Queens-Rocket-Engineering-Team/av-prop/Schematics/lower_lc_board/models/1053141106.stp

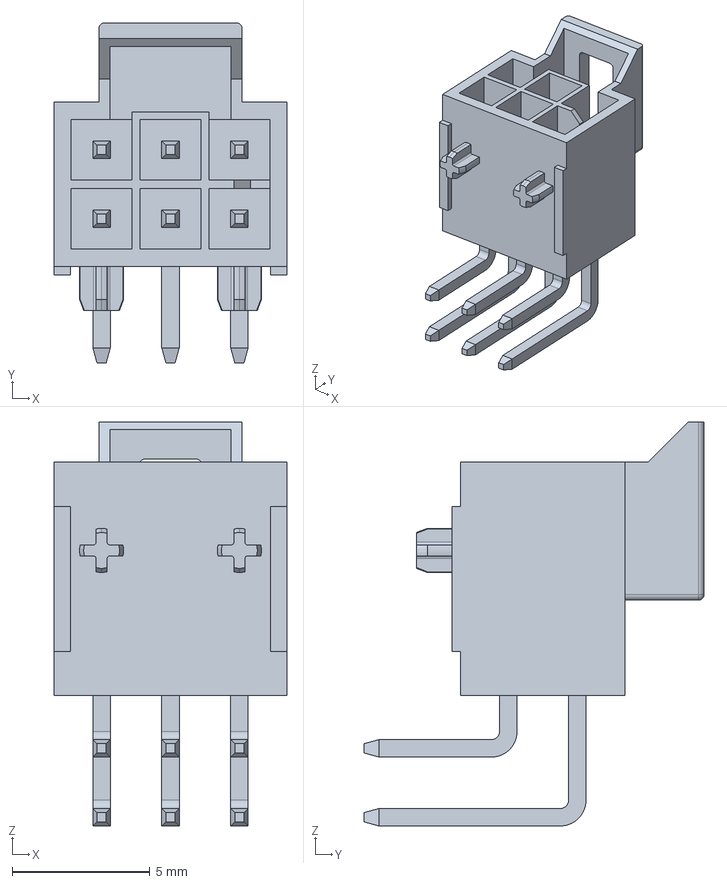
[picture p8: CAD file, 2026-06-11]
Schematics/lower_lc_board/models/1053141106.stp
8.44 x 12.3 x 14.7 mm
