Queens-Rocket-Engineering-Team/av-prop/Schematics/lower_lc_board/models/1984769.stp

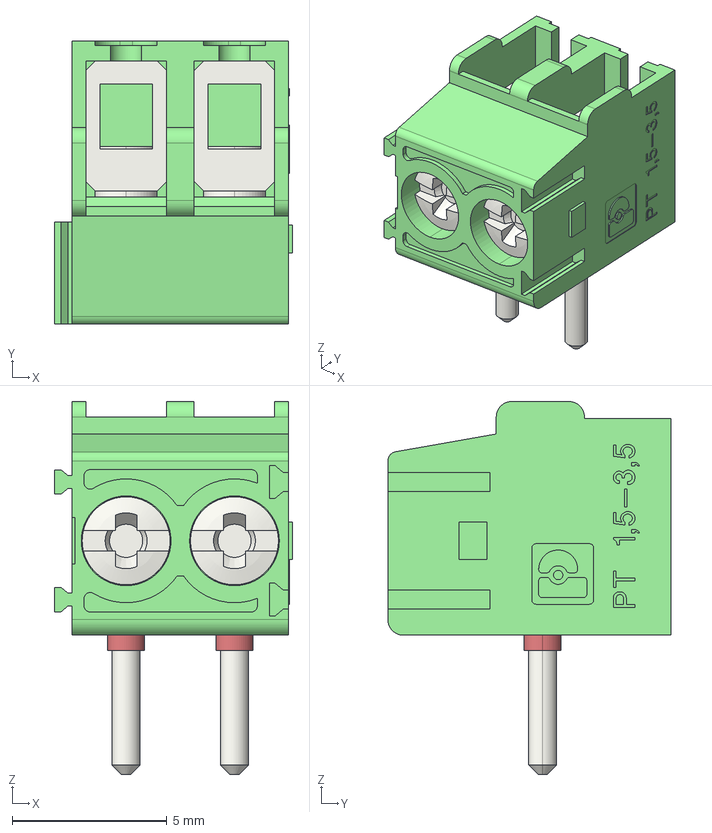
[picture p9: CAD file, 2026-06-11]
Schematics/lower_lc_board/models/1984769.stp
7.70 x 9.15 x 12.1 mm
Bohrloch x 2
AC_PT_1_5_PVH_H0_Schraube x 2
LP_PT_1_5_KLH_3_5 x 2
PT_1.5_3_3.50_V_GEH
