Queens-Rocket-Engineering-Team/av-prop/Schematics/lower_lc_board/lower_lc_board.kicad_pcb

## KiCad design Schematics/lower_lc_board/lower_lc_board.kicad_pcb (2026-06-11)

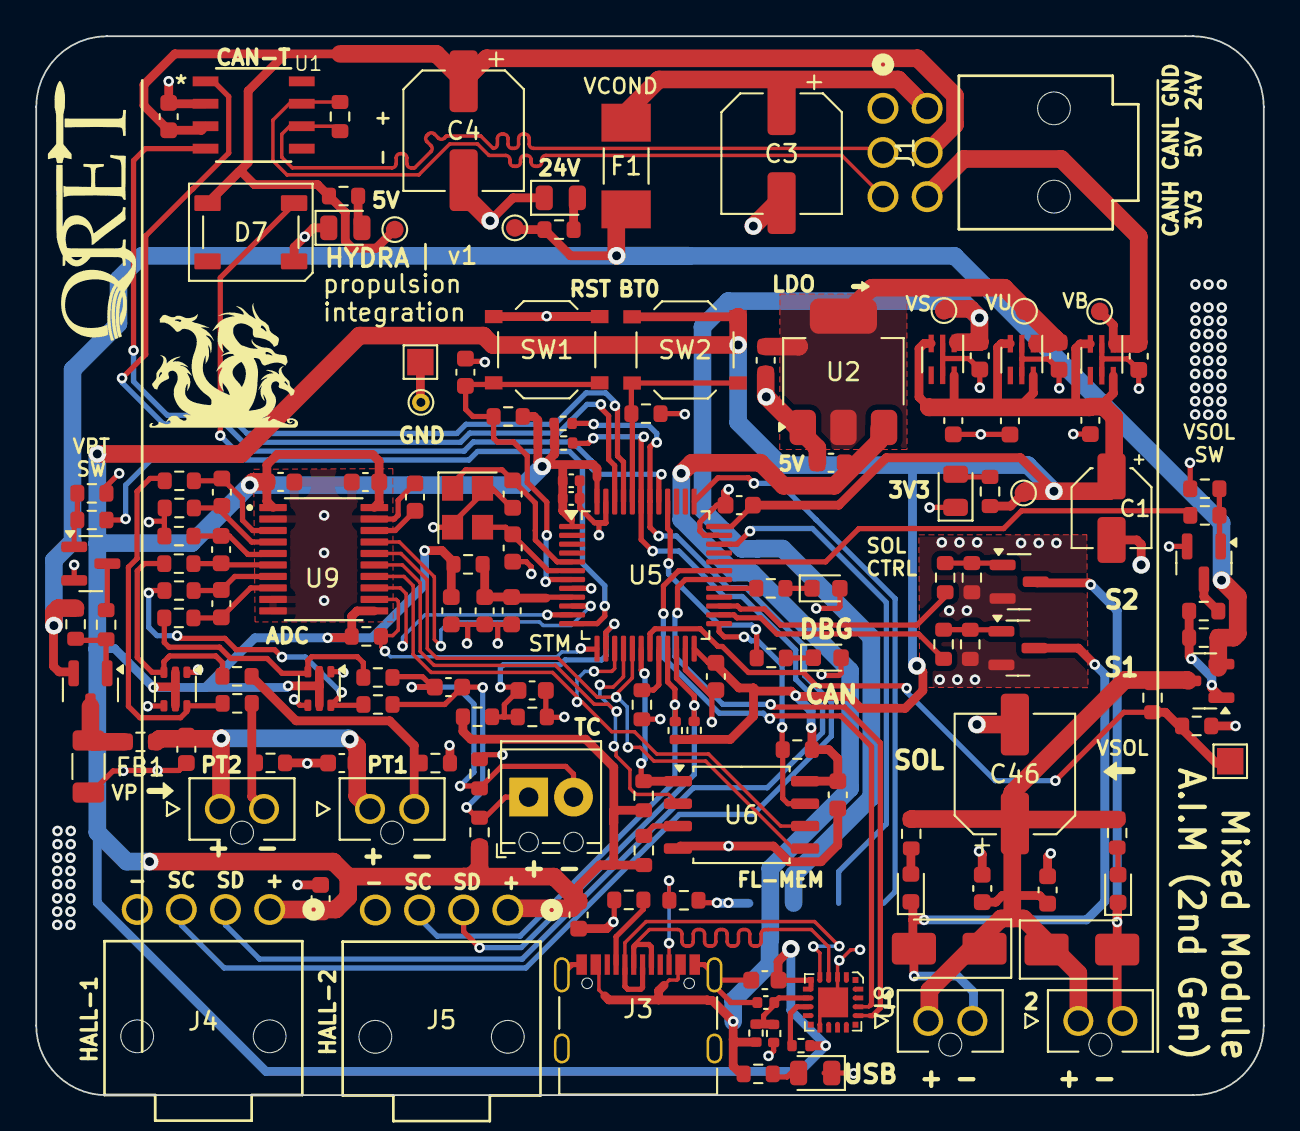
[picture p10: board lower_lc_board.kicad_pcb from above]

Board: 4 copper layers, 69.5 x 60.0 mm, 149 parts (1 on the bottom side), 86 nets.

Parts:
C1: 10uF; CP_Elec_4x5.4
C2, C18, C23, C30, C33, C39, C41, C45, C52: 0.1uF; C_0603_1608Metric
C3, C4, C46: 100uF; CP_Elec_6.3x5.9
C5, C6, C28, C43, C44, C48, C49: 1uF; C_0603_1608Metric
C7, C12, C21, C50: 10uF; C_0603_1608Metric
C8, C9, C17: 100nF; C_0603_1608Metric
C10, C11: 10p; C_0603_1608Metric
C13, C14: 100n; C_0402_1005Metric
C15, C16: 100n; C_0603_1608Metric
C20: 1uF; C_0402_1005Metric
C26, C27, C34, C56: 10nF; C_0603_1608Metric
C29: 220 nF; C_0603_1608Metric
C35: 10uF; C_1206_3216Metric
C51: 1nF; C_0603_1608Metric
D1: PWR_3V3_LED (GRN); LED_0805_2012Metric
D2: PWR_24V_LED (GRN); LED_0805_2012Metric
D3: PWR_5V_LED (GRN); LED_0805_2012Metric
D4: USB_LED (GRN); LED_0805_2012Metric
D5: DB_LED (YLW); LED_0603_1608Metric
D6: CAN_LED (WHT); LED_0603_1608Metric
D7: SYS_LED; LED_WS2812B_PLCC4_5.0x5.0mm_P3.2mm
D11: SOL2_LED (YELW); LED_0603_1608Metric
D12: SOL1_LED (YELW); LED_0603_1608Metric
D13, D18: BAV199DW; SOT-363_SC-70-6
D15, D16: SS34; D_SMA
F1: Fuse; FUSC6125X279N
FB1, FB2: 600R; R_0603_1608Metric
J1: Conn_01x06; CONN_SD-105314-100_06_MOL
J2: SWD_CONN; SWD_PinHeader_1x04_P2.54mm_Horizontal_SMD
J3: USB_C_CONN; USB_C_DB-108PWB
J4: HALL-1; CONN_SD-105313-100_04_MOL
J5: HALL-2; CONN_SD-105313-100_04_MOL
J6, J8: PT; MOLEX_1053091102
J7: Screw_Terminal_01x02; TerminalBlock_Phoenix_MPT-0,5-2-2.54_1x02_P2.54mm_Horizontal
J9, J10: SOL_CONN; MOLEX_1053091102
Q1, Q2: AO3400A; SOT-23
Q3, Q5: 2N7002; SOT-23
R1: 3.3k; R_0603_1608Metric
R2, R30, R31: 12k; R_0603_1608Metric
R3, R16, R23, R51: 6.2k; R_0603_1608Metric
R5, R6, R7, R8, R22, R25, R43, R48, R49, R50, R52, R54, R60: 10k; R_0603_1608Metric
R9, R10: 5.1k; R_0603_1608Metric
R11: 22k; R_0402_1005Metric
R12: 47k; R_0402_1005Metric
R13: 1k; R_0402_1005Metric
R14: 680; R_0603_1608Metric
R15: 270; R_0603_1608Metric
R17, R18, R21, R45: 2.2k; R_0402_1005Metric
R19, R20: 1.2k; R_0603_1608Metric
R24, R28, R33, R37: 1k; R_0603_1608Metric
R26, R27: 1M; R_0603_1608Metric
R29, R34, R36, R38, R40, R41, R44, R53: 200; R_0603_1608Metric
R32, R35: 62; R_0603_1608Metric
R39, R42, R47: 100k; R_0603_1608Metric
R46: 120; R_0603_1608Metric
SW1: SW_STM_RESET; SW_Push_1P1T_XKB_TS-1187A
SW2: SW_STM_BOOT_MODE; SW_Push_1P1T_XKB_TS-1187A
TH1: Thermistor; R_0603_1608Metric
TP1: 24V-TP; TestPoint_Pad_D1.0mm
TP2: 3V3-TP; TestPoint_Pad_D1.0mm
TP3: GND-TP-H; TestPoint_THTPad_D1.0mm_Drill0.5mm
TP4: 3V3_BP; TestPoint_Pad_D1.0mm
TP5: GND-TP-P; TestPoint_Pad_1.5x1.5mm
TP6: 3V3_USB; TestPoint_Pad_D1.0mm
TP7: VSOL.S; TestPoint_Pad_1.5x1.5mm
TP9: V_SWD_TP; TestPoint_Pad_D1.0mm
TP13: 5V-TP; TestPoint_Pad_D1.0mm
U1: TCAN1051HGVDR; SOIC_1044BDR_TEX
U2: AMS1117-3.3; SOT-223-3_TabPin2
U3, U4, U10: ID_LM66100DCKR; SC-70-6
U5: STM32F103CBT6; LQFP-48_7x7mm_P0.5mm
U6: BY25Q128ES; SOIC-8_5.23x5.23mm_P1.27mm
U8: CP2102N-Axx-xQFN20; QFN-20-1EP_3x3mm
U9: ADC_ADS131M04IPWR; SOP65P640X120-20N
U11, U12: DMP4065S-7; SOT-23
Y1: X322516MMB4SI; Crystal_SMD_3225-4Pin_3.2x2.5mm

Connections:
5V_USB: C7.1, J3.A4 (VBUS), J3.A9 (VBUS), J3.B4 (VBUS), J3.B9 (VBUS), R11.2, R16.1, U2.3 (VI)
+3.3VA: C45.2, C48.2, FB2.1, U5.9 (VDDA)
+3V3: C1.1, C13.1, C14.1, C15.1, C16.1, C17.1, C21.2, C23.1, C28.2, C30.2, C33.1, C43.2, C49.1, C50.1, C51.1, C52.1, D13.2 (K2), D13.5 (K4), D18.2 (K2), D18.5 (K4), FB2.2, J4.1, J5.1, J7.1, R1.1, R6.2, R7.2, R8.2, R13.2, R17.2, R18.1, R21.2, R24.2, R25.2, R26.1, R26.2, R45.1, R48.1, R49.2, SW2.2, TP2.1, U3.3 (*CE), U3.6 (VOUT), U4.3 (*CE), U4.6 (VOUT), U5.1 (VBAT), U5.24 (VDD), U5.36 (VDD), U5.48 (VDD), U6.8 (VCC), U8.6 (VDD), U8.7 (VREGIN), U9.1 (AVDD), U9.11 (~SYNC/~RESET), U9.20 (DVDD), U10.3 (*CE), U10.6 (VOUT)
+5V: C4.1, C9.2, D7.1 (VDD), J1.5, R3.2, TP13.1, U1.3 (VCC)
+24V: F1.1, R2.2, R23.2, R51.2, TP1.1, U11.2 (S), U12.2 (S)
+24V_BP: C3.1, F1.2, J1.4
/Power Circuitry/3V3_BP: C5.2, J1.6, TP4.1, U3.1 (VIN)
/Power Circuitry/3V3_USB: C6.1, C12.1, TP6.1, U2.2 (VO), U4.1 (VIN)
/Sensing Circuitry/PT1_CLAMPED: C26.2, R34.1, U9.3 (AIN0P)
/Sensing Circuitry/PT2_CLAMPED: C27.2, R38.1, U9.6 (AIN1P)
/Sensing Circuitry/TC_N_1: C30.1, J7.2, R27.1, R28.2
/Sensing Circuitry/TC_N_CLAMPED_1: C56.1, R40.2, U9.8 (AIN2N)
/Sensing Circuitry/TC_P_CLAMPED_1: C56.2, R29.2, U9.7 (AIN2P)
/Valve Control Circuitry/VSOL: C39.1, C41.1, C46.1, D15.1 (K), D16.1 (K), J9.1, J10.1, R30.2, R31.2, R47.1, U12.3 (D)
ADC_CLKIN: U5.10 (PA0), U9.17 (CLKIN)
ADC_CS: R49.1, U5.13 (PA3), U9.12 (~CS)
ADC_DRDY: U5.11 (PA1), U9.13 (~DRDY)
BOOT0: R5.2, SW2.1, U5.44 (BOOT0)
BOOT1: R60.2, U5.20 (PB2)
CAN_LED: R15.1, U5.40 (PB4)
CAN_N: J1.2, R46.1, U1.6 (CANL)
CAN_P: J1.3, R46.2, U1.7 (CANH)
CAN_RX: U1.4 (RXD), U5.45 (PB8)
CAN_TX: U1.1 (TXD), U5.46 (PB9)
CJC_SENSE: C34.2, R25.1, TH1.1, U5.14 (PA4)
DB_LED: R14.1, U5.29 (PA8)
FL_CS: R48.2, U5.18 (PB0), U6.1 (~CS)
GND: C1.2, C2.2, C3.2, C4.2, C5.1, C6.2, C7.2, C8.2, C9.1, C10.2, C11.2, C12.2, C13.2, C14.2, C15.2, C16.2, C17.2, C18.2, C20.1, C21.1, C23.2, C28.1, C29.2, C33.2, C34.1, C35.2, C39.2, C41.2, C43.1, C44.2, C45.1, C46.2, C48.1, C49.2, C50.2, C51.2, C52.2, D1.1 (K), D2.1 (K), D3.1 (K), D4.1 (K), D5.2 (A), D6.2 (A), D7.3 (VSS), D13.1 (A1), D13.4 (A3), D18.1 (A1), D18.4 (A3), J1.1, J2.1 (GND), J3.A1 (GND), J3.A12 (GND), J3.B1 (GND), J3.B12 (GND), J3.S1 (SHIELD), J4.4, J5.4, Q1.2 (S), Q2.2 (S), Q3.2 (S), Q5.2 (S), R5.1, R9.2, R10.2, R12.1, R19.1, R20.1, R27.2, R32.1, R35.1, R39.1, R42.1, R43.1, R52.1, R54.1, R60.1, SW1.1, TH1.2, TP3.1, TP5.1, U1.2 (GND), U2.1 (ADJ), U3.2 (GND), U3.5 (ST), U4.2 (GND), U4.5 (ST), U5.8 (VSSA), U5.23 (VSS), U5.35 (VSS), U5.47 (VSS), U6.4 (GND), U8.3 (GND), U8.12 (GND), U8.21 (GND), U9.2 (AGND), U9.9 (AIN3N), U9.10 (AIN3P), U9.19 (DGND), U10.2 (GND), U10.5 (ST), Y1.2, Y1.4
HALL_SCL1: J4.3, R18.2, U5.42 (PB6)
HALL_SCL2: J5.3, R45.2, U5.21 (PB10)
HALL_SDA1: J4.2, R17.1, U5.43 (PB7)
HALL_SDA2: J5.2, R21.1, U5.22 (PB11)
unnamed: D1.2 (A), R1.2
unnamed: D2.2 (A), R2.1
unnamed: D3.2 (A), R3.1
unnamed: D4.2 (A), R16.2
unnamed: D5.1 (K), R14.2
unnamed: D6.1 (K), R15.2
unnamed: D11.2 (A), R30.1
unnamed: D12.2 (A), R31.1
unnamed: D13.6 (K3A4), R33.2, R34.2
unnamed: D13.3 (K1A2), R37.2, R38.2
unnamed: D18.6 (K3A4), R24.1, R29.1
unnamed: D18.3 (K1A2), R28.1, R40.1
unnamed: J3.A5 (CC1), R9.1
unnamed: J3.B5 (CC2), R10.1
unnamed: J6.2, R32.2, R33.1
unnamed: J8.2, R35.2, R37.1
unnamed: Q1.1 (G), R36.1, R39.2
unnamed: Q2.1 (G), R41.1, R42.2
unnamed: Q3.3 (D), R22.1
unnamed: Q3.1 (G), R43.2, R44.2
unnamed: Q5.3 (D), R50.1
unnamed: Q5.1 (G), R52.2, R53.2
unnamed: R8.1, U6.3 (IO2)
unnamed: C20.2, R11.1, R12.2, U8.8 (VBUS)
unnamed: R13.1, U8.9 (~RST)
unnamed: C26.1, R19.2, U9.4 (AIN0N)
unnamed: C27.1, R20.2, U9.5 (AIN1N)
unnamed: C29.1, U9.18 (CAP)
unnamed: C35.1, FB1.2, U11.3 (D)
unnamed: R22.2, R23.1, U11.1 (G)
unnamed: R50.2, R51.1, U12.1 (G)
OSC_IN: C10.1, U5.5 (PD0), Y1.1
OSC_OUT: C11.1, U5.6 (PD1), Y1.3
RESET_FL: R7.1, U5.25 (PB12), U6.7 (IO3)
RGB_DATA: D7.4 (DIN), U5.41 (PB5)
SOL1_EN: R36.2, U5.26 (PB13)
SOL1_RET: D12.1 (K), D16.2 (A), J10.2, Q1.3 (D)
SOL2_EN: R41.2, U5.27 (PB14)
SOL2_RET: D11.1 (K), D15.2 (A), J9.2, Q2.3 (D)
SPI_MISO: U5.16 (PA6), U6.2 (DO(IO1)), U9.15 (DOUT)
SPI_MOSI: U5.17 (PA7), U6.5 (DI(IO0)), U9.16 (DIN)
SPI_SCLK: U5.15 (PA5), U6.6 (CLK), U9.14 (SCLK)
STM_RESET: C8.1, R6.1, SW1.2, U5.7 (NRST)
SWCLK: J2.4 (SWCLK), U5.37 (PA14)
SWDIO: J2.3 (SWDIO), U5.34 (PA13)
USART_RX: U5.31 (PA10), U8.18 (TXD)
USART_TX: U5.30 (PA9), U8.17 (RXD)
USB_N: J3.A7 (D-), J3.B7 (D-), U8.5 (D-)
USB_P: J3.A6 (D+), J3.B6 (D+), U8.4 (D+)
VPT: C2.1, C18.1, FB1.1, J6.1, J8.1
VPT_EN: R44.1, U5.12 (PA2)
VSOL_EN: R53.1, U5.32 (PA11)
VSOL_SENSE: R47.2, R54.2, TP7.1, U5.19 (PB1)
V_SWD: C44.1, J2.2 (3V3), TP9.1, U10.1 (VIN)
