Queens-Rocket-Engineering-Team/av-prop/Schematics/upper_lc_board/upper_lc_board.kicad_pcb

## KiCad design Schematics/upper_lc_board/upper_lc_board.kicad_pcb (2026-06-11)

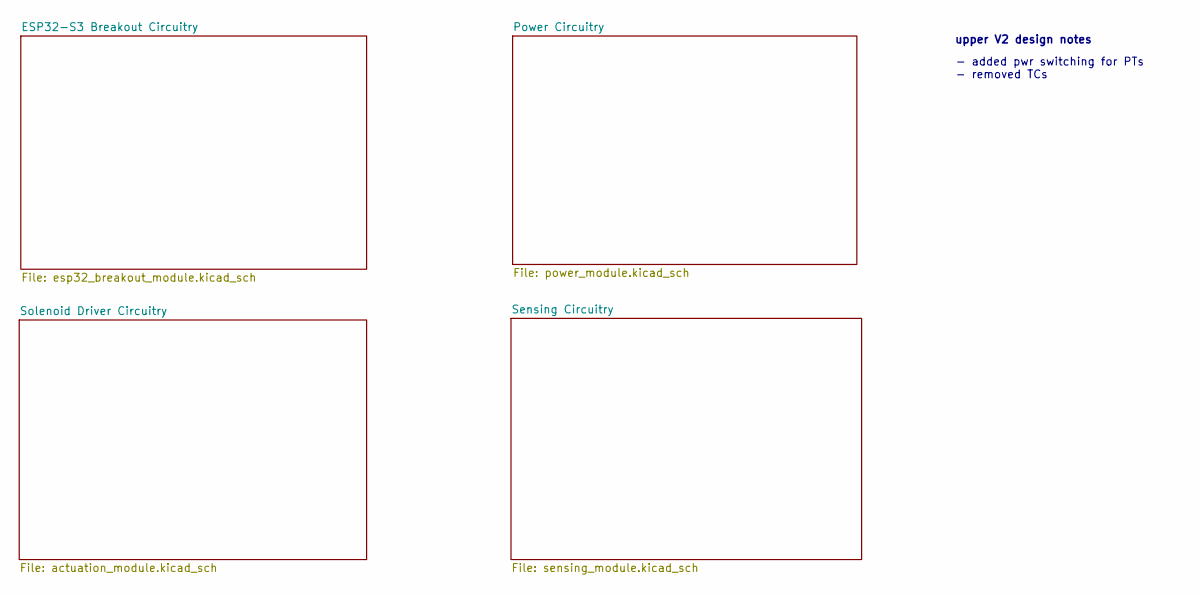
[picture p11: schematic upper_lc_board.kicad_sch, QRET 25-26 SRAD Hybrid Upper Control Module]

Notes on the sheet:
- added pwr switching for PTs - removed TCs
upper V2 design notes

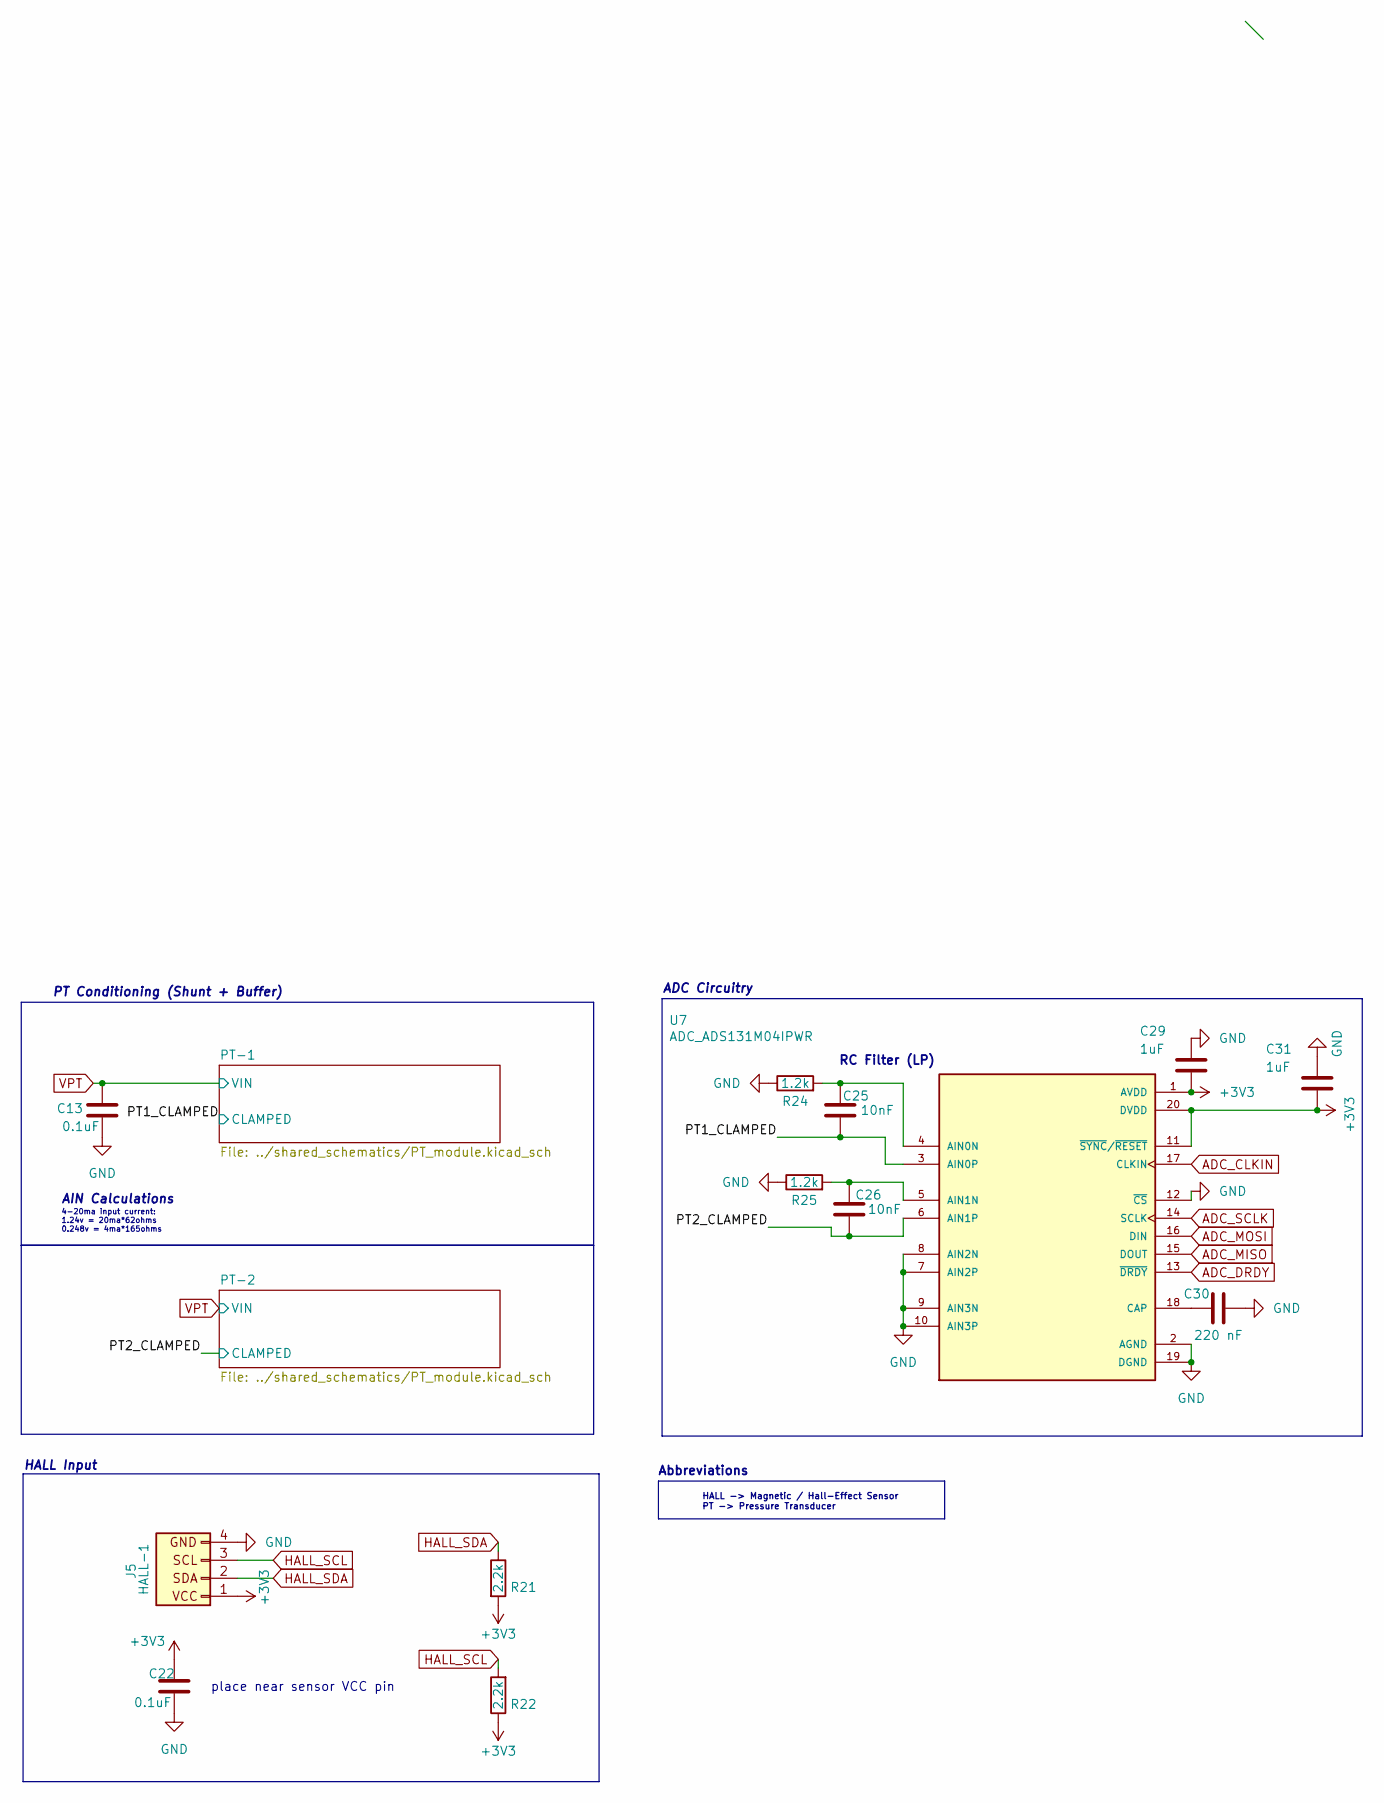
[picture p12: schematic sensing_module.kicad_sch, Sensing Circuitry]

Parts:
C13, C22: 0.1uF; C_0603_1608Metric; LCSC C14663
C25, C26: 10nF; C_0603_1608Metric; LCSC C57112
C29, C31: 1uF; C_0603_1608Metric; LCSC C15849
C30: 220 nF; C_0603_1608Metric; LCSC C21120
J5: HALL-1; CONN_SD-105313-100_04_MOL; Digikey WM16895-ND
R21, R22: 2.2k; R_0603_1608Metric; LCSC C4190
R24, R25: 1.2k; R_0603_1608Metric; LCSC C22765
U7: ADC_ADS131M04IPWR; SOP65P640X120-20N; PARTREV D; LCSC C2862562

Connections:
+3V3: C22.1, C29.2, C31.2, J5.1, R21.2, R22.1, U7.1 (AVDD), U7.11 (~SYNC/~RESET), U7.20 (DVDD); also elsewhere on the board
/Sensing Circuitry/PT1_CLAMPED: C25.2, U7.3 (AIN0P); also elsewhere on the board
/Sensing Circuitry/PT2_CLAMPED: C26.2, U7.6 (AIN1P); also elsewhere on the board
ADC_CLKIN: U7.17 (CLKIN); also elsewhere on the board
ADC_DRDY: U7.13 (~DRDY); also elsewhere on the board
ADC_MISO: U7.15 (DOUT); also elsewhere on the board
ADC_MOSI: U7.16 (DIN); also elsewhere on the board
ADC_SCLK: U7.14 (SCLK); also elsewhere on the board
GND: C13.2, C22.2, C29.1, C30.2, C31.1, J5.4, R24.1, R25.1, U7.2 (AGND), U7.7 (AIN2P), U7.8 (AIN2N), U7.9 (AIN3N), U7.10 (AIN3P), U7.12 (~CS), U7.19 (DGND); also elsewhere on the board
HALL_SCL: J5.3, R22.2; also elsewhere on the board
HALL_SDA: J5.2, R21.1; also elsewhere on the board
unnamed: C25.1, R24.2, U7.4 (AIN0N)
unnamed: C26.1, R25.2, U7.5 (AIN1N)
unnamed: C30.1, U7.18 (CAP)
VPT: C13.1; also elsewhere on the board

Notes on the sheet:
4-20ma input current: 1.24v = 20ma*62ohms 0.248v = 4ma*165ohms
HALL -> Magnetic / Hall-Effect Sensor PT -> Pressure Transducer
place near sensor VCC pin
ADC Circuitry
AIN Calculations
RC Filter (LP)
HALL Input
PT Conditioning (Shunt + Buffer)
Abbreviations

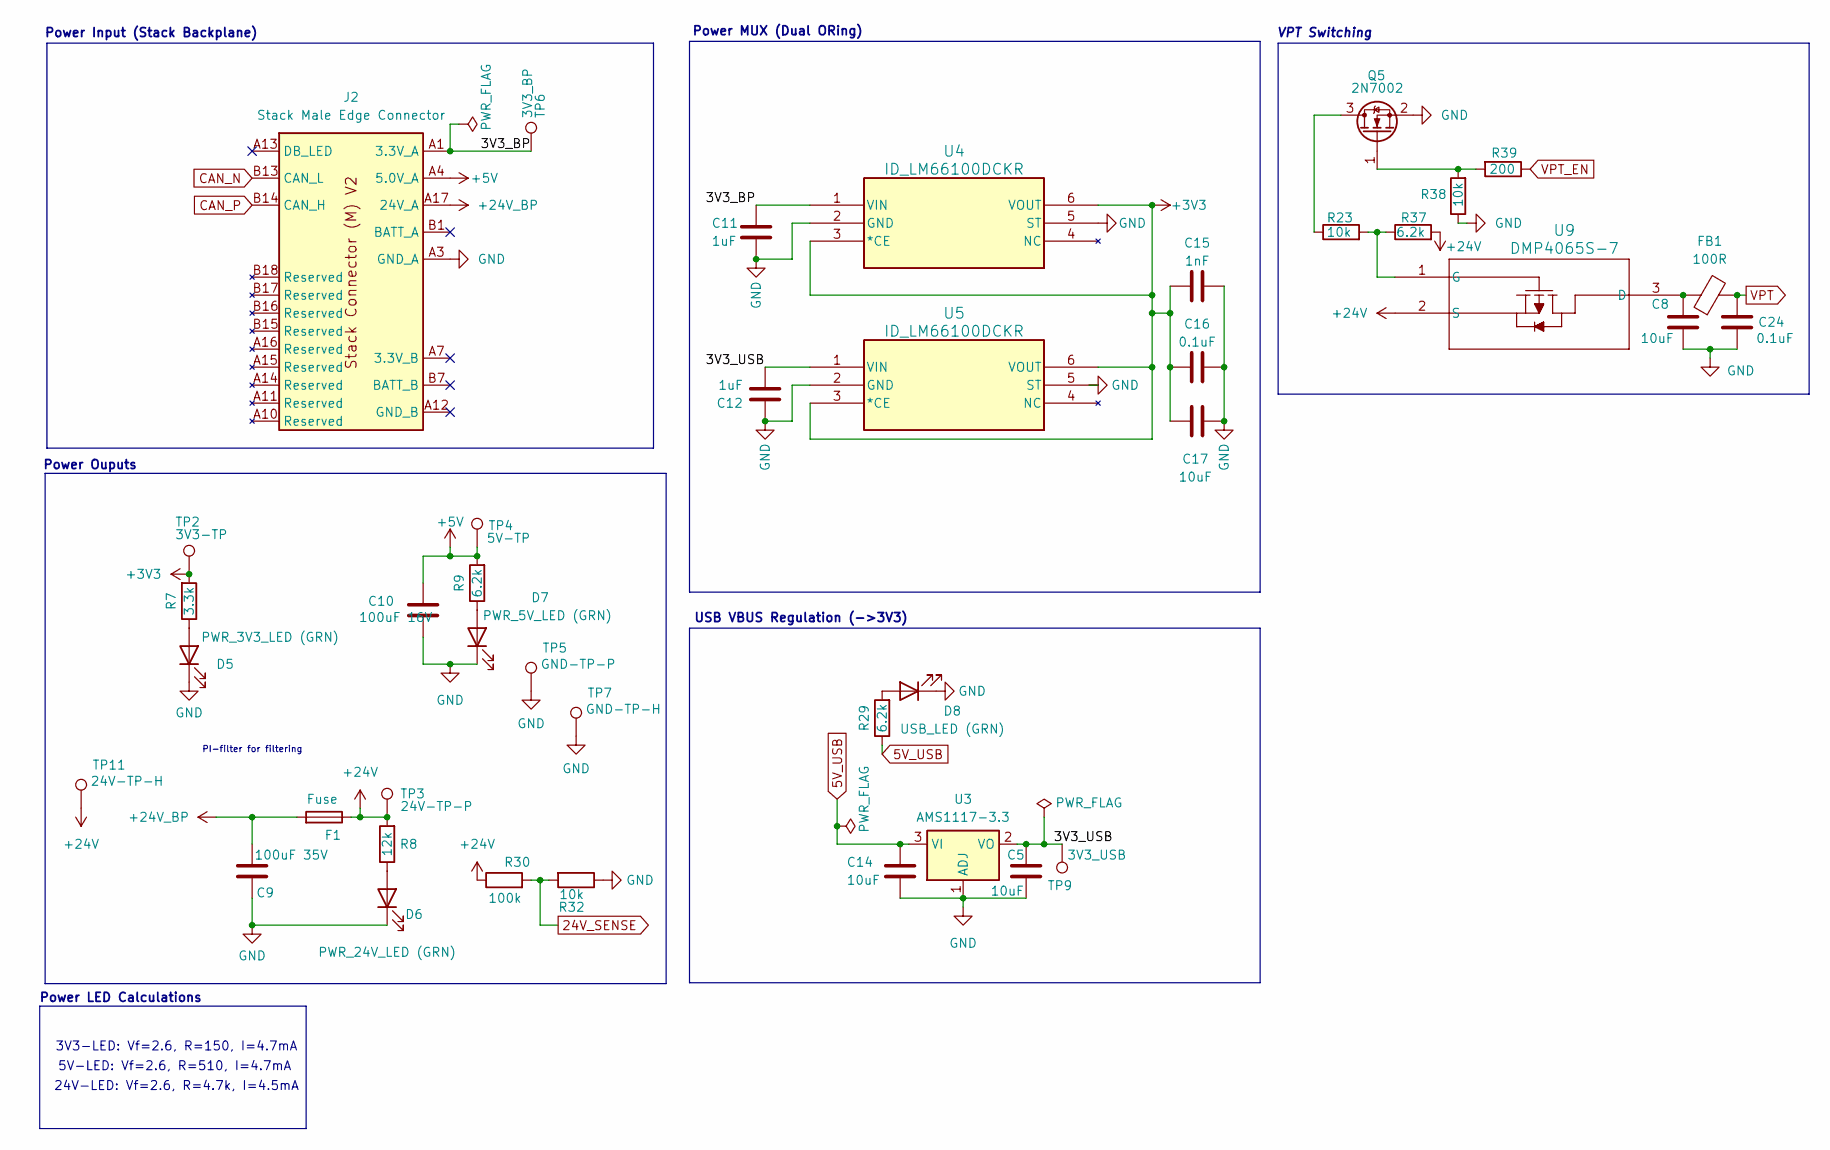
[picture p13: schematic power_module.kicad_sch, Power Management Circuitry]

Parts:
C5, C8, C14, C17: 10uF; C_0603_1608Metric; LCSC C96446
C9: 100uF 35V; CP_Elec_6.3x5.9; Digikey 732-8511-1-ND
C10: 100uF 16V; CP_Elec_6.3x5.9; Digikey 732-8419-1-ND
C11, C12: 1uF; C_0603_1608Metric; LCSC C15849
C15: 1nF; C_0603_1608Metric; LCSC C1588
C16, C24: 0.1uF; C_0603_1608Metric; LCSC C14663
D5: PWR_3V3_LED (GRN); LED_0805_2012Metric; LCSC C2297
D6: PWR_24V_LED (GRN); LED_0805_2012Metric; LCSC C2297
D7: PWR_5V_LED (GRN); LED_0805_2012Metric; LCSC C2297
D8: USB_LED (GRN); LED_0805_2012Metric; LCSC C2297
F1: Fuse; FUSC6125X279N; Digikey 5923-0679H2000-05CT-ND
FB1: 100R; R_0805_2012Metric; LCSC C1015
J2: Stack Male Edge Connector; BUS_PCIexpress_x1
Q5: 2N7002; SOT-23; LCSC C8545
R7: 3.3k; R_0603_1608Metric; LCSC C22978
R8: 12k; R_0603_1608Metric; LCSC C22790
R9, R29, R37: 6.2k; R_0603_1608Metric; LCSC C4260
R23, R32, R38: 10k; R_0603_1608Metric; LCSC C25804
R30: 100k; R_0603_1608Metric; LCSC C25803
R39: 200; R_0603_1608Metric; LCSC C8218
TP2: 3V3-TP; TestPoint_Pad_D1.0mm
TP3: 24V-TP-P; TestPoint_Pad_1.5x1.5mm
TP4: 5V-TP; TestPoint_Pad_D1.0mm
TP5: GND-TP-P; TestPoint_Pad_1.5x1.5mm
TP6: 3V3_BP; TestPoint_Pad_D1.0mm
TP7: GND-TP-H; TestPoint_THTPad_D1.0mm_Drill0.5mm
TP9: 3V3_USB; TestPoint_Pad_D1.0mm
TP11: 24V-TP-H; TestPoint_THTPad_D1.0mm_Drill0.5mm
U3: AMS1117-3.3; SOT-223-3_TabPin2; LCSC C6186
U4, U5: ID_LM66100DCKR; SC-70-6; LCSC C2869734
U9: DMP4065S-7; SOT-23; LCSC C182476

Connections:
5V_USB: C14.1, R29.1, U3.3 (VI); also elsewhere on the board
24V_SENSE: R30.2, R32.2; also elsewhere on the board
+3V3: C15.1, C16.1, C17.1, R7.2, TP2.1, U4.3 (*CE), U4.6 (VOUT), U5.3 (*CE), U5.6 (VOUT); also elsewhere on the board
+5V: C10.1, J2.A4 (5.0V_A), J2.A5 (5.0V_A), R9.2, TP4.1; also elsewhere on the board
+24V: F1.1, R8.2, R30.1, R37.2, TP3.1, TP11.1, U9.2 (S); also elsewhere on the board
+24V_BP: C9.1, F1.2, J2.A17 (24V_A), J2.A18 (24V_A)
/Power Circuitry/3V3_BP: C11.2, J2.A1 (3.3V_A), J2.A2 (3.3V_A), TP6.1, U4.1 (VIN)
/Power Circuitry/3V3_USB: C5.1, C12.1, TP9.1, U3.2 (VO), U5.1 (VIN)
CAN_N: J2.B13 (CAN_L); also elsewhere on the board
CAN_P: J2.B14 (CAN_H); also elsewhere on the board
GND: C5.2, C8.2, C9.2, C10.2, C11.1, C12.2, C14.2, C15.2, C16.2, C17.2, C24.2, D5.1 (K), D6.1 (K), D7.1 (K), D8.1 (K), J2.A3 (GND_A), J2.A6 (GND_A), J2.B4 (GND_A), J2.B5 (GND_A), J2.B6 (GND_A), Q5.2 (S), R32.1, R38.1, TP5.1, TP7.1, U3.1 (ADJ), U4.2 (GND), U4.5 (ST), U5.2 (GND), U5.5 (ST); also elsewhere on the board
unnamed: D5.2 (A), R7.1
unnamed: D6.2 (A), R8.1
unnamed: D7.2 (A), R9.1
unnamed: D8.2 (A), R29.2
unnamed: Q5.3 (D), R23.1
unnamed: Q5.1 (G), R38.2, R39.2
unnamed: C8.1, FB1.1, U9.3 (D)
unnamed: R23.2, R37.1, U9.1 (G)
VPT: C24.1, FB1.2; also elsewhere on the board
VPT_EN: R39.1; also elsewhere on the board

Notes on the sheet:
Power Input (Stack Backplane)
24V-LED: Vf=2.6, R=4.7k, I=4.5mA
3V3-LED: Vf=2.6, R=150, I=4.7mA
Power MUX (Dual ORing)
5V-LED: Vf=2.6, R=510, I=4.7mA
VPT Switching
Power Ouputs
Power LED Calculations
PI-filter for filtering
USB VBUS Regulation (->3V3)

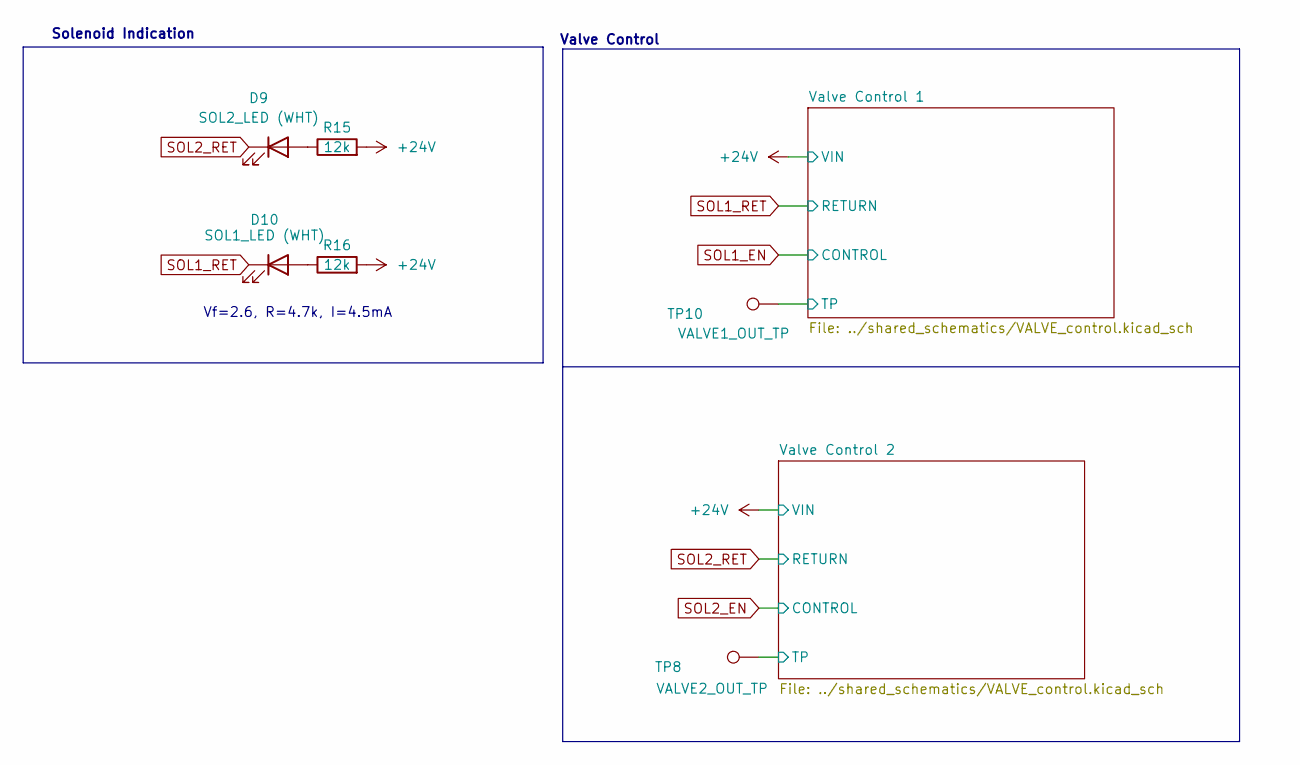
[picture p14: schematic actuation_module.kicad_sch, Solenoid Driver Circuitry]

Parts:
D9: SOL2_LED (WHT); LED_0603_1608Metric; LCSC C2290
D10: SOL1_LED (WHT); LED_0603_1608Metric; LCSC C2290
R15, R16: 12k; R_0603_1608Metric; LCSC C22790
TP8: VALVE2_OUT_TP; TestPoint_Pad_1.5x1.5mm
TP10: VALVE1_OUT_TP; TestPoint_Pad_1.5x1.5mm

Connections:
+24V: R15.2, R16.2; also elsewhere on the board
unnamed: D9.2 (A), R15.1
unnamed: D10.2 (A), R16.1
SOL1_RET: D10.1 (K), TP10.1; also elsewhere on the board
SOL2_RET: D9.1 (K), TP8.1; also elsewhere on the board

Notes on the sheet:
Valve Control
Vf=2.6, R=4.7k, I=4.5mA
Solenoid Indication

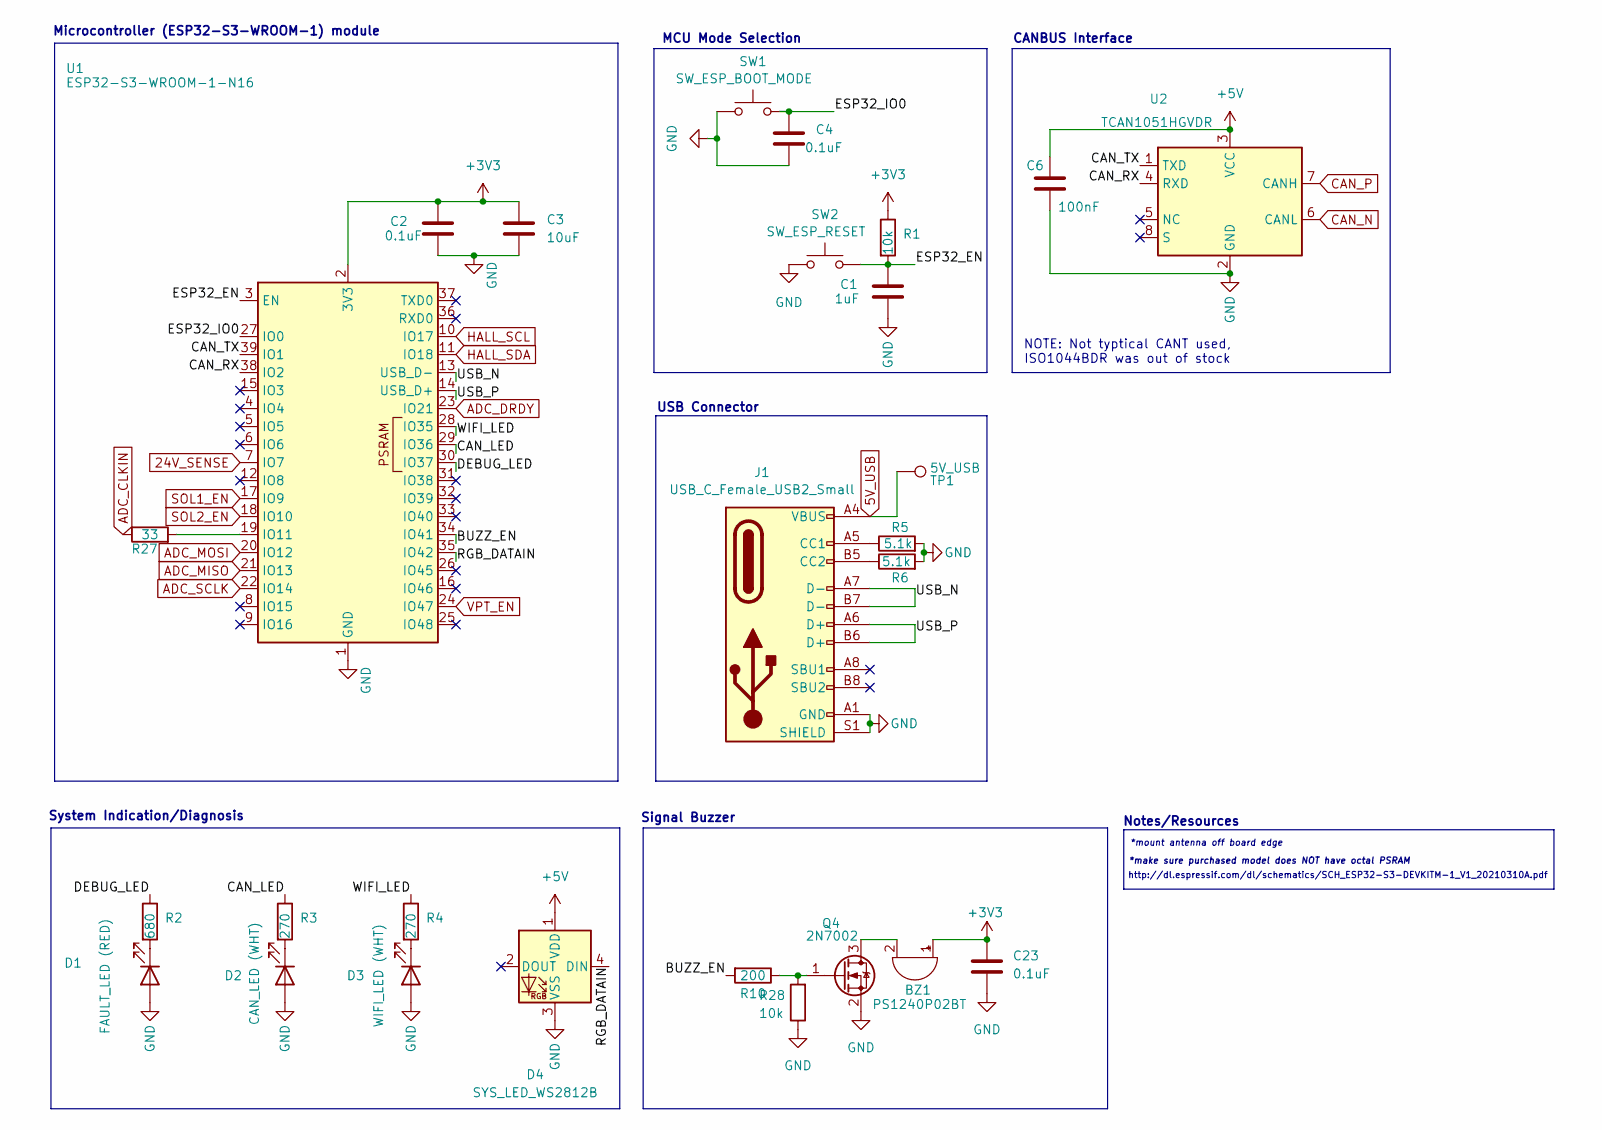
[picture p15: schematic esp32_breakout_module.kicad_sch, ESP32-S3 Breakout Circuitry]

Parts:
BZ1: PS1240P02BT; Buzzer_12.6x9.5RM5.0; Digikey 445-2525-1-ND
C1: 1uF; C_0603_1608Metric; LCSC C15849
C2, C4, C23: 0.1uF; C_0603_1608Metric; LCSC C14663
C3: 10uF; C_0603_1608Metric; LCSC C96446
C6: 100nF; C_0603_1608Metric; LCSC C14663
D1: FAULT_LED (RED); LED_0603_1608Metric; LCSC C2286
D2: CAN_LED (WHT); LED_0603_1608Metric; LCSC C2290
D3: WIFI_LED (WHT); LED_0603_1608Metric; LCSC C2290
D4: SYS_LED_WS2812B; LED_WS2812B_PLCC4_5.0x5.0mm_P3.2mm; Digikey 1568-COM-16347CT-ND
J1: USB_C_Female_USB2_Small; USB_C_Receptacle_GCT_USB4105-xx-A_16P_TopMnt_Horizontal; LCSC C5178541
Q4: 2N7002; SOT-23; LCSC C8545
R1, R28: 10k; R_0603_1608Metric; LCSC C25804
R2: 680; R_0603_1608Metric; LCSC C23228
R3, R4: 270; R_0603_1608Metric; LCSC C22966
R5, R6: 5.1k; R_0603_1608Metric; LCSC C23186
R10: 200; R_0603_1608Metric; LCSC C8218
R27: 33; R_0603_1608Metric; LCSC C23140
SW1: SW_ESP_BOOT_MODE; SW_Push_1P1T_XKB_TS-1187A; LCSC C318884
SW2: SW_ESP_RESET; SW_Push_1P1T_XKB_TS-1187A; LCSC C318884
TP1: 5V_USB; TestPoint_Pad_D1.0mm
U1: ESP32-S3-WROOM-1-N16; ESP32-S3-WROOM-1; Digikey 5407-ESP32-S3-WROOM-1-N16CT-ND
U2: TCAN1051HGVDR; SOIC_1044BDR_TEX; Digikey 296-44225-1-ND

Connections:
5V_USB: J1.A4 (VBUS), J1.A9 (VBUS), J1.B4 (VBUS), J1.B9 (VBUS), TP1.1; also elsewhere on the board
24V_SENSE: U1.7 (IO7); also elsewhere on the board
+3V3: BZ1.1 (+), C2.1, C3.1, C23.1, R1.1, U1.2 (3V3); also elsewhere on the board
+5V: C6.2, D4.1 (VDD), U2.3 (VCC); also elsewhere on the board
/ESP32-S3 Breakout Circuitry/BUZZ_IN: R10.2, U1.34 (IO41)
/ESP32-S3 Breakout Circuitry/CAN_LED: R3.1, U1.29 (IO36)
/ESP32-S3 Breakout Circuitry/CAN_RX: U1.38 (IO2), U2.4 (RXD)
/ESP32-S3 Breakout Circuitry/CAN_TX: U1.39 (IO1), U2.1 (TXD)
/ESP32-S3 Breakout Circuitry/DEBUG_LED: R2.1, U1.30 (IO37)
/ESP32-S3 Breakout Circuitry/ESP32_EN: C1.1, R1.2, SW2.2, U1.3 (EN)
/ESP32-S3 Breakout Circuitry/ESP32_IO0: C4.2, SW1.2, U1.27 (IO0)
/ESP32-S3 Breakout Circuitry/RGB_DATAIN: D4.4 (DIN), U1.35 (IO42)
/ESP32-S3 Breakout Circuitry/USB_N: J1.A7 (D-), J1.B7 (D-), U1.13 (USB_D-)
/ESP32-S3 Breakout Circuitry/USB_P: J1.A6 (D+), J1.B6 (D+), U1.14 (USB_D+)
/ESP32-S3 Breakout Circuitry/WIFI_LED: R4.1, U1.28 (IO35)
ADC_CLKIN: R27.1; also elsewhere on the board
ADC_DRDY: U1.23 (IO21); also elsewhere on the board
ADC_MISO: U1.21 (IO13); also elsewhere on the board
ADC_MOSI: U1.20 (IO12); also elsewhere on the board
ADC_SCLK: U1.22 (IO14); also elsewhere on the board
CAN_N: U2.6 (CANL); also elsewhere on the board
CAN_P: U2.7 (CANH); also elsewhere on the board
GND: C1.2, C2.2, C3.2, C4.1, C6.1, C23.2, D1.2 (A), D2.2 (A), D3.2 (A), D4.3 (VSS), J1.A1 (GND), J1.A12 (GND), J1.B1 (GND), J1.B12 (GND), J1.S1 (SHIELD), Q4.2 (S), R5.2, R6.2, R28.1, SW1.1, SW2.1, U1.1 (GND), U1.40 (GND), U1.41 (GND), U2.2 (GND); also elsewhere on the board
HALL_SCL: U1.10 (IO17); also elsewhere on the board
HALL_SDA: U1.11 (IO18); also elsewhere on the board
unnamed: BZ1.2 (-), Q4.3 (D)
unnamed: D1.1 (K), R2.2
unnamed: D2.1 (K), R3.2
unnamed: D3.1 (K), R4.2
unnamed: J1.A5 (CC1), R5.1
unnamed: J1.B5 (CC2), R6.1
unnamed: Q4.1 (G), R10.1, R28.2
unnamed: R27.2, U1.19 (IO11)
SOL1_EN: U1.17 (IO9); also elsewhere on the board
SOL2_EN: U1.18 (IO10); also elsewhere on the board
VPT_EN: U1.24 (IO47); also elsewhere on the board

Notes on the sheet:
CANBUS Interface
Microcontroller (ESP32-S3-WROOM-1) module
*mount antenna off board edge
*make sure purchased model does NOT have octal PSRAM
NOTE: Not typtical CANT used, ISO1044BDR was out of stock
Notes/Resources
MCU Mode Selection
USB Connector
http://dl.espressif.com/dl/schematics/SCH_ESP32-S3-DEVKITM-1_V1_20210310A.pdf
Signal Buzzer
System Indication/Diagnosis

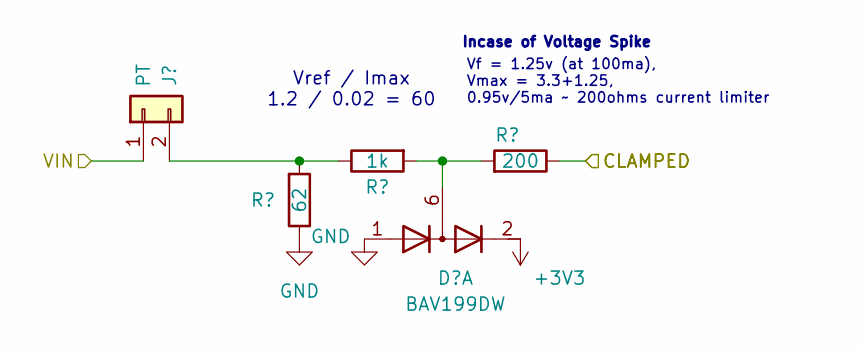
[picture p16: schematic PT_module.kicad_sch, Pressure Transducer Circuitry]

Parts:
D11: BAV199DW; SOT-363_SC-70-6; LCSC C459846
J3: PT; MOLEX_1053091102; Digikey WM14965-ND
R11: 62; R_0603_1608Metric; LCSC C23222
R12: 1k; R_0603_1608Metric; LCSC C21190
R13: 200; R_0603_1608Metric; LCSC C8218

Connections:
+3V3: D11.2 (K2), D11.5 (K4); also elsewhere on the board
/Sensing Circuitry/PT1_CLAMPED: R13.1; also elsewhere on the board
GND: D11.1 (A1), D11.4 (A3), R11.1; also elsewhere on the board
unnamed: D11.6 (K3A4), R12.2, R13.2
unnamed 42: D11.3 (K1A2); also elsewhere on the board
unnamed: J3.2, R11.2, R12.1
VPT: J3.1; also elsewhere on the board

Parts of its further copies:
J4: PT; MOLEX_1053091102; Digikey WM14965-ND
R14: 62; R_0603_1608Metric; LCSC C23222
R17: 1k; R_0603_1608Metric; LCSC C21190
R18: 200; R_0603_1608Metric; LCSC C8218

Connections of its further copies:
/Sensing Circuitry/PT2_CLAMPED: R18.1; also elsewhere on the board
GND: R14.1; also elsewhere on the board
unnamed 42: R17.2, R18.2; also elsewhere on the board
unnamed: J4.2, R14.2, R17.1
VPT: J4.1; also elsewhere on the board

Notes on the sheet:
Vf = 1.25v (at 100ma), Vmax = 3.3+1.25, 0.95v/5ma ~ 200ohms current limiter
Incase of Voltage Spike
Vref / Imax 1.2 / 0.02 = 60

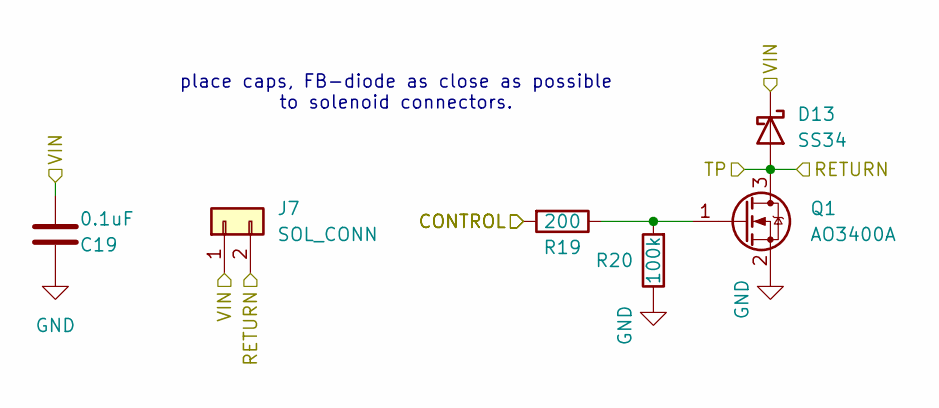
[picture p17: schematic VALVE_control.kicad_sch, Valve Control Module]

Parts:
C19: 0.1uF; C_0603_1608Metric; LCSC C14663
D13: SS34; D_SMA; Digikey 5399-SS34CT-ND
J7: SOL_CONN; MOLEX_1053091102; Digikey WM14965-ND
Q1: AO3400A; SOT-23; LCSC C20917
R19: 200; R_0603_1608Metric; LCSC C8218
R20: 100k; R_0603_1608Metric; LCSC C25803

Connections:
+24V: C19.1, D13.1 (K), J7.1; also elsewhere on the board
GND: C19.2, Q1.2 (S), R20.1; also elsewhere on the board
unnamed: Q1.1 (G), R19.1, R20.2
SOL1_EN: R19.2; also elsewhere on the board
SOL1_RET: D13.2 (A), J7.2, Q1.3 (D); also elsewhere on the board

Parts of its further copies:
C21: 0.1uF; C_0603_1608Metric; LCSC C14663
D14: SS34; D_SMA; Digikey 5399-SS34CT-ND
J6: SOL_CONN; MOLEX_1053091102; Digikey WM14965-ND
Q2: AO3400A; SOT-23; LCSC C20917
R26: 200; R_0603_1608Metric; LCSC C8218
R31: 100k; R_0603_1608Metric; LCSC C25803

Connections of its further copies:
+24V: C21.1, D14.1 (K), J6.1; also elsewhere on the board
GND: C21.2, Q2.2 (S), R31.1; also elsewhere on the board
unnamed: Q2.1 (G), R26.1, R31.2
SOL2_EN: R26.2; also elsewhere on the board
SOL2_RET: D14.2 (A), J6.2, Q2.3 (D); also elsewhere on the board

Notes on the sheet:
place caps, FB-diode as close as possible to solenoid connectors.
