Queens-Rocket-Engineering-Team/av-prop/Schematics/upper_lc_board/upper_lc_board.kicad_pcb

## KiCad design Schematics/upper_lc_board/upper_lc_board.kicad_pcb (continued)

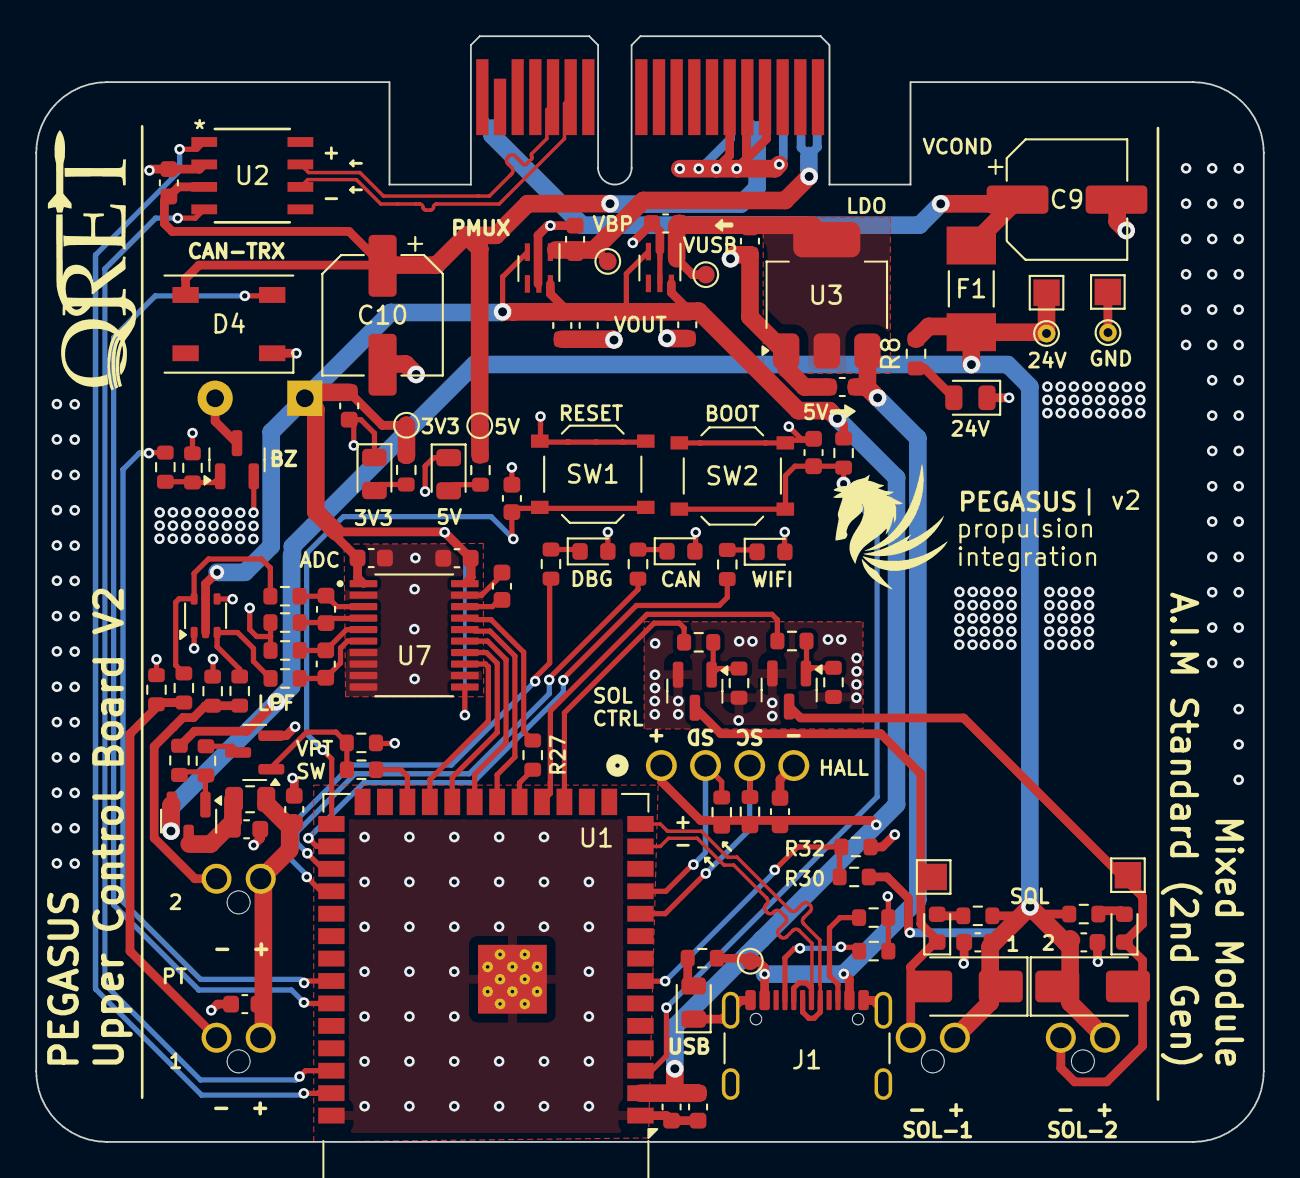
[picture p18: board upper_lc_board.kicad_pcb from above]

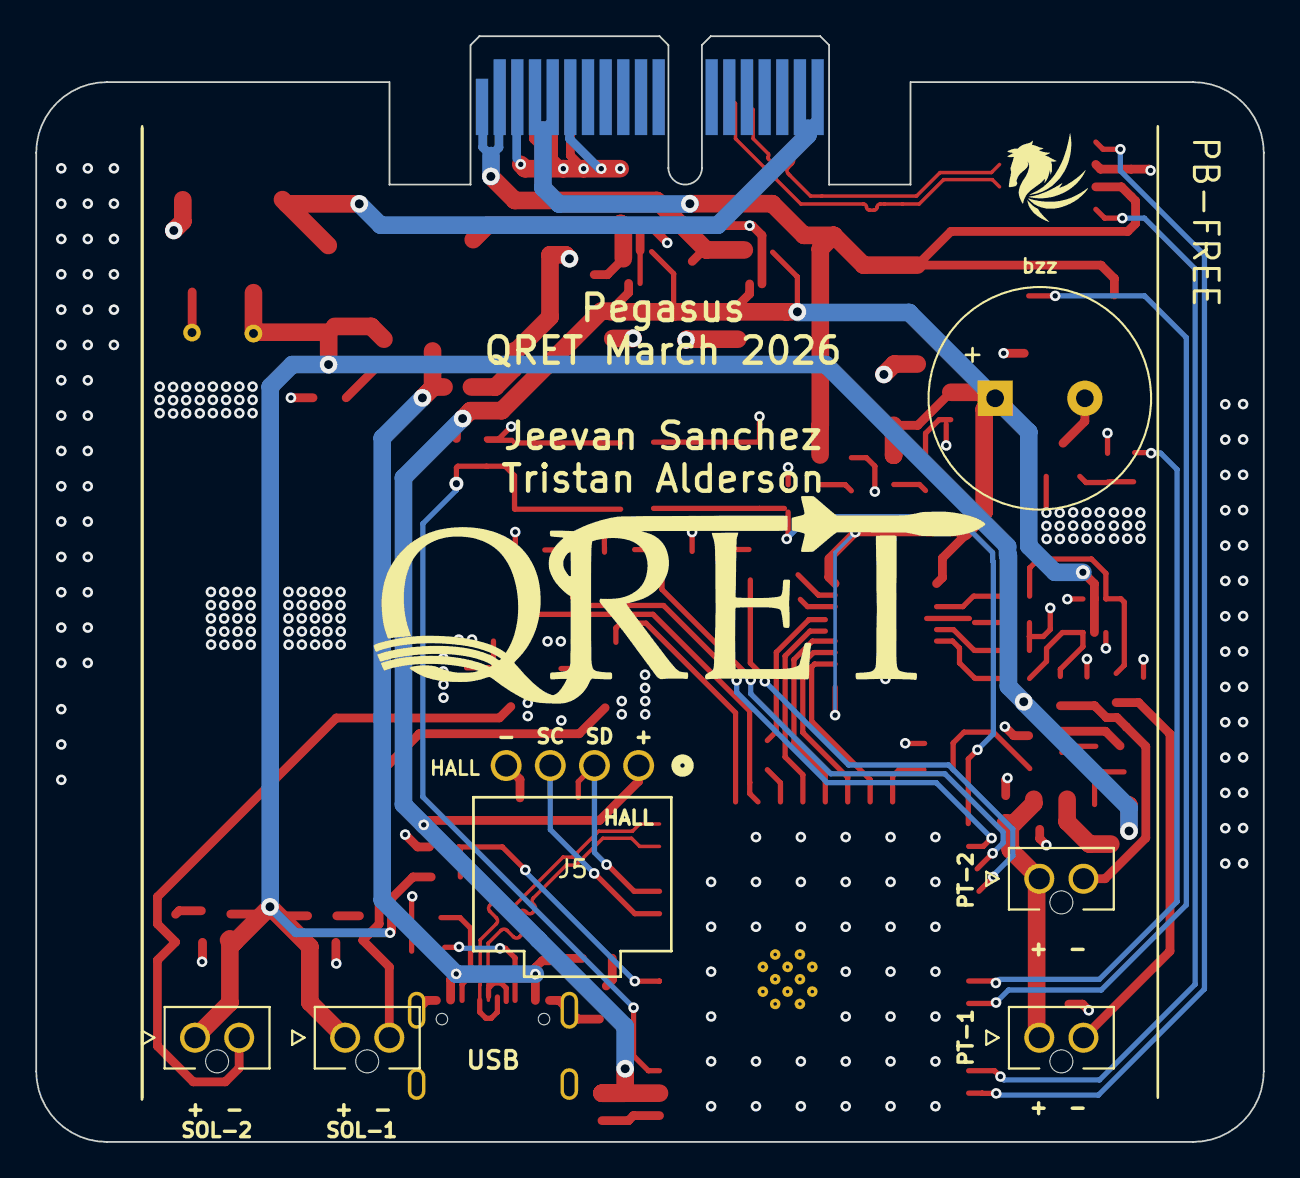
[picture p19: board upper_lc_board.kicad_pcb from below]

Board: 4 copper layers, 69.5 x 62.6 mm, 108 parts (6 on the bottom side), 64 nets.
