Queens-Rocket-Engineering-Team/av-prop/Firmware/Upper_Control/src/node.cpp

#include "node.h"

#include <freertos/FreeRTOS.h>
#include <freertos/semphr.h>
#include <freertos/task.h>

#include <ADS131M04.h>
#include <SPI.h>
#include <logger.h>
#include <aim_control.h>
#include <aim_sensor.h>
#include <aim_job.h>
#include <aim_flight_recorder.h>
#include <prop_testing.h>
#include <atomic>
#include <cstring>
#include <WiFi.h>
#include <esp_timer.h>

extern "C" {
#include "wifi_tools.h"
#include <qlcp_lib.h>
}

#define WIFI_SSID "QRET-PAD"
#define WIFI_PASS "Mach2@69"

static SemaphoreHandle_t s_nodeMutex = nullptr;

struct NodeLock {
  NodeLock() {
    if (s_nodeMutex != nullptr) {
      (void)xSemaphoreTake(s_nodeMutex, portMAX_DELAY);
    }
  }
  ~NodeLock() {
    if (s_nodeMutex != nullptr) {
      (void)xSemaphoreGive(s_nodeMutex);
    }
  }
};

static bool s_boardHardwareReady = false;

// Seven controls, indexed to match the QLCP control_id / cmdId contract.
// Two local valves + one local power FET that this board owns, plus four LCM
// controls driven remotely over CAN.
enum UcmControl : uint8_t {
  kCtrlAv204,     // 0: local vent
  kCtrlAvSpare,   // 1: local (SOL2)
  kCtrlAv203,     // 2: remote (LCM)
  kCtrlAv205,     // 3: remote (LCM)
  kCtrlPwrPtUcm,  // 4: PwrPtUcm  local  PT power FET
  kCtrlPwrSolLcm, // 5: PwrSolLcm remote (LCM)
  kCtrlPwrPtLcm,  // 6: PwrPtLcm  remote (LCM)
  kCtrlCount
};
static aim::Control s_controls[kCtrlCount];

// Seven scalar sensors by catalog subject — four PTs, a thermocouple, two voltage
// senses — sampled locally off the UCM ADC or received from the LCM over CAN.
// Indices 0..3 are the PTs, matching the QLCP sensor_id contract (Pt202..PtSpare2).
enum UcmSensor : uint8_t {
  kSenPt202,     // 0: local  — UCM ADC
  kSenPt102,     // 1: local  — UCM ADC; wire subject is still aim::subject::PtSpare1 (0x13)
  kSenVolt24,    // 2: local  — UCM 24V sense
  kSenVsol,      // 3: remote — LCM VSOL sense
  kSenCount
};
static aim::Sensor s_sensors[kSenCount];
static uint32_t s_lowerLastRxMs = 0U;
static bool     s_lowerLinkUp   = false;
constexpr uint32_t kNetEStopTimeoutMs   = 300000U; // 5-minute WiFi/QLCP loss E-Stop watchdog
constexpr uint32_t kLowerEStopTimeoutMs = 300000U; // 5-minute Lower CAN loss E-Stop watchdog

// Link age, wrap-safe. RX stamps are written with a *different* millis() call than the
// check (serviceCanRx before nowMs; qlcpTask on Core 0), so lastRx can sit 1 ms ahead of
// nowMs. Unsigned subtraction turns that into ~49 days and fires the 5-min E-stop instantly
// (seen on the pad); a signed cast makes it read as "just now" instead.
static inline int32_t linkAgeMs(uint32_t nowMs, uint32_t lastRxMs) {
  return static_cast<int32_t>(nowMs - lastRxMs);
}
// Cleared on Core 0 (qlcpTask RX) and set on Core 1 (nodeUpdate) — atomic, no lock needed.
static std::atomic<bool> s_wifiEStopSafed{false};
static bool     s_lcmEStopSafed         = false;

static ADS131M04 s_adc(-1, pins::kAdcDrdy, &SPI);
constexpr uint8_t kAdcClockChannel = 0U;
constexpr uint32_t kAdcClockHz = 8192000U;
constexpr uint8_t kAdcClockDuty = 1U;
constexpr uint32_t kTelemetryPeriodMs  = 100U;
constexpr uint32_t kLowerStaleTimeoutMs = 2000U; // 2.0s tolerates 1 missed frame from 1 Hz LCM broadcast

constexpr size_t kAdcChannelCount = 4U;

// ADC channel for each UCM-local PT.
constexpr uint8_t kAdcChPt202 = 0U;
constexpr uint8_t kAdcChPt102 = 1U;

// Full-scale range of the transducer physically installed on each UCM channel.
// Feeds the 4-20 mA conversion in prop_testing.cpp; the shunt (kPtShuntOhms)
// is still shared by both channels.
constexpr float kPt202MaxPsi = 1000.0f;
constexpr float kPt102MaxPsi = 508.0f;

static aim::Job s_logJob(50U);                  // 20 Hz flight log
static aim::Job s_telemetryJob(20U);            // 50 Hz CAN broadcast of 24 V sense + local valve states
static aim::Job s_timeSyncCanJob(1000U);        // 1 Hz CAN TimeSync master broadcast

constexpr char kBoardQlcpConfigJson[] = R"json({
  "device_name": "PEGASUS-UPPER",
  "sensors": {
    "pressure_transducer": {
      "PT202": {
        "unit": "PSI"
      },
      "PT102": {
        "unit": "PSI"
      }
    },
    "voltage_sense": {
      "Volt24Ucm": {
        "sensor_index": "Volt24Ucm",
        "unit": "V"
      },
      "VoltSolLcm": {
        "sensor_index": "VoltSolLcm",
        "unit": "V"
      }
    }
  },
  "controls": {
    "valve": {
      "AV204": {
        "default_state": "OPEN",
        "type": "BOOL",
        "unit": "bool"
      },
      "AVSPARE": {
        "default_state": "OPEN",
        "type": "BOOL",
        "unit": "bool"
      },
      "AV203": {
        "default_state": "OPEN",
        "type": "BOOL",
        "unit": "bool"
      },
      "AV205": {
        "default_state": "CLOSED",
        "type": "BOOL",
        "unit": "bool"
      }
    },
    "relay": {
      "PwrPtUpper": {
        "default_state": "OPEN",
        "type": "BOOL",
        "unit": "bool"
      },
      "PwrSolLower": {
        "default_state": "OPEN",
        "type": "BOOL",
        "unit": "bool"
      },
      "PwrPtLower": {
        "default_state": "OPEN",
        "type": "BOOL",
        "unit": "bool"
      }
    }
  }
})json";

static uint32_t s_pendingServerTimeMs  = 0U;   // 0: no pending time sync

enum QlcpNetState : uint8_t {
  QLCP_NET_IDLE = 0U,
  QLCP_NET_WIFI_START,
  QLCP_NET_WIFI_WAIT,
  QLCP_NET_DISCOVER,
  QLCP_NET_TCP_CONNECT,
  QLCP_NET_CONNECTED,
  QLCP_NET_BACKOFF
};

constexpr uint32_t kNetWifiWaitTimeoutMs  = 15000U;
constexpr uint32_t kNetTcpConnectTimeoutMs = 5000U;
constexpr uint32_t kNetRxIdleTimeoutMs    = 30000U;  // 6 server heartbeats (5 s cadence)
constexpr uint32_t kNetBackoffMinMs       = 500U;
constexpr uint32_t kNetBackoffMaxMs       = 2000U;   // discovery socket is closed during backoff — keep the blind window short
constexpr uint16_t kMaxStreamHz           = 500U;    // 1000/freq rounds to a 1 ms flood above this

constexpr uint32_t kTimesyncIntervalMs = 60000U;

static net_link_t   s_netLink = {};
static QlcpNetState s_netState = QLCP_NET_IDLE;
static uint32_t     s_stateEnteredMs = 0U;
static std::atomic<uint32_t> s_lastRxMs{0U};   // written Core 0 (qlcpTask), read Core 1 (E-stop timer)
static uint32_t     s_backoffMs = kNetBackoffMinMs;
static bool         s_configSent = false;
static uint16_t     s_sequence = 0U;
static uint16_t     s_streamFrequencyHz = 0U;
static uint32_t     s_lastStreamTxMs = 0U;
static aim::Job     s_qlcpTimeSyncJob(kTimesyncIntervalMs);

// Control picture as of the last STATUS the server actually received, and the
// latch saying it has gone stale since. Guarded by NodeLock.
static uint16_t     s_reportedFingerprint = 0U;
static bool         s_statusDirty = false;

static void fillHeader(qlcp_header& header) {
  header.sequence = static_cast<uint8_t>(s_sequence++);
  header.timestamp_us = static_cast<uint64_t>(g_aim.syncedMillis()) * 1000ULL;
}

static void netTransition(QlcpNetState next, uint32_t nowMs) {
  LOG_DEBUG("QLCP net: %u -> %u", s_netState, next);
  s_netState = next;
  s_stateEnteredMs = nowMs;
}

static void netFail(uint32_t nowMs) {
  net_link_close_all(&s_netLink);
  s_streamFrequencyHz = 0U;
  s_configSent = false;
  {
    // The next session starts with no control picture at all — owe it one
    // unsolicited STATUS as soon as CONFIG lands, without waiting to be asked.
    NodeLock lock;
    s_statusDirty = true;
  }
  netTransition(QLCP_NET_BACKOFF, nowMs);
}

static void qlcpNetService(uint32_t nowMs);
static void qlcpTelemetryService(uint32_t nowMs);

// Helper to force all controls to safe default (valves first, then power FETs after 100 ms delay)
static void triggerEStop(const char* reason) {
  LOG_ERROR("E-Stop triggered (%s) — safing valves first, then power FETs", reason ? reason : "Unknown");
  {
    NodeLock lock;
    // 1. Safe all solenoid valves (indices 0..3)
    for (uint8_t i = kCtrlAv204; i <= kCtrlAv205; i++) {
      controlSetDefault(s_controls[i]);
    }
    s_statusDirty = true;
  }

  // 2. Allow coils to collapse magnetic field before cutting rail power
  delay(100);

  {
    NodeLock lock;
    // 3. Safe all power FETs (indices 4..6)
    for (uint8_t i = kCtrlPwrPtUcm; i < kCtrlCount; i++) {
      controlSetDefault(s_controls[i]);
    }
    s_statusDirty = true;
  }
}

// Command a control by its QLCP/cmdId index. Local controls actuate immediately;
// remote controls queue a Cmd that nodeServiceCanTx sends to the LCM.
static bool setControlByIndex(uint8_t index, bool open) {
  if (index >= kCtrlCount) {
    return false;
  }
  NodeLock lock;
  controlSet(s_controls[index], open);
  return true;
}

static void sendAck(uint8_t ackType, uint16_t ackSeq) {
  qlcp_server_payload out = {};
  out.packet_type = QLCP_PT_ACK;
  fillHeader(out.payload_data.ack.header);
  out.payload_data.ack.ack_packet_type = ackType;
  out.payload_data.ack.ack_sequence = ackSeq;
  if (tcp_tx_payload(&s_netLink, &out) != 0) {
    LOG_DEBUG("ACK dropped — TX busy");
  }
}

static void sendNack(uint8_t nackType, uint16_t nackSeq, uint8_t errCode) {
  qlcp_server_payload out = {};
  out.packet_type = QLCP_PT_NACK;
  fillHeader(out.payload_data.nack.header);
  out.payload_data.nack.nack_packet_type = nackType;
  out.payload_data.nack.nack_sequence = nackSeq;
  out.payload_data.nack.nack_error_code = errCode;
  if (tcp_tx_payload(&s_netLink, &out) != 0) {
    LOG_DEBUG("NACK dropped — TX busy");
  }
}

// A remote control is PENDING from the moment a Cmd is queued until the LCM has
// both Acked that sequence (awaitingAck clears) and broadcast a State frame
// carrying the new position (state catches up to desiredOpen). Requiring both
// closes the window where the Ack has landed but `state` still holds the old
// position — reporting CONFIRMED there would attach a stale value.
// Local controls actuate on the calling thread, so they are never pending.
// Caller holds NodeLock.
static bool ctrlIsPending(const aim::Control& c) {
  return (c.kind == aim::ControlKind::Remote) &&
         (c.awaitingAck || (c.state != c.desiredOpen));
}

// Everything STATUS reports, packed for cheap comparison: low kCtrlCount bits
// are the reported state of each control, high bits its pending flag. When this
// drifts from what the server last saw, an unsolicited STATUS is owed.
// Caller holds NodeLock.
static uint16_t statusFingerprint() {
  uint16_t fp = 0U;
  for (uint8_t i = 0U; i < kCtrlCount; i++) {
    const aim::Control& c = s_controls[i];
    const bool pending = ctrlIsPending(c);
    if (pending ? c.desiredOpen : c.state) {
      fp = static_cast<uint16_t>(fp | (1U << i));
    }
    if (pending) {
      fp = static_cast<uint16_t>(fp | (1U << (i + kCtrlCount)));
    }
  }
  return fp;
}

// STATUS is the required response to CONTROL, STATUS_REQUEST, and ESTOP — it
// doubles as the ack for whichever of those triggered it (ackType/ackSeq).
// ackType == QLCP_PT_NO_ACK marks a device-initiated update (spec 7.2); the
// server skips command-response tracking on those and ackSeq is free.
static void sendStatus(uint8_t ackType, uint16_t ackSeq) {
  qlcp_status_data controlData[kCtrlCount] = {};
  uint16_t fingerprint = 0U;
  {
    NodeLock lock;
    for (uint8_t i = 0U; i < kCtrlCount; i++) {
      const aim::Control& c = s_controls[i];
      const bool pending = ctrlIsPending(c);
      controlData[i].id = i;
      controlData[i].type = QLCP_CONTROL_BOOL;
      controlData[i].status = pending ? QLCP_CONTROL_STATUS_PENDING
                                      : QLCP_CONTROL_STATUS_CONFIRMED;
      // Spec 7.2: PENDING carries the last commanded state, CONFIRMED the actual one.
      controlData[i].state.control_bool =
          (pending ? c.desiredOpen : c.state) ? QLCP_CS_OPEN : QLCP_CS_CLOSED;
    }
    fingerprint = statusFingerprint();
  }
  qlcp_server_payload out = {};
  out.packet_type = QLCP_PT_STATUS;
  fillHeader(out.payload_data.status.header);
  out.payload_data.status.ack_packet_type = ackType;
  out.payload_data.status.ack_sequence = static_cast<uint8_t>(ackSeq);
  out.payload_data.status.control_data = controlData;
  out.payload_data.status.control_count = kCtrlCount;
  if (tcp_tx_payload(&s_netLink, &out) != 0) {
    LOG_DEBUG("STATUS dropped — TX busy");
    return;  // s_statusDirty stays latched; qlcpStatusService retries next tick
  }
  NodeLock lock;
  s_reportedFingerprint = fingerprint;
  s_statusDirty = false;
}

// Device-initiated: sent once right after CONFIG is queued, then every
// kTimesyncIntervalMs. The server echoes our send time back (t1_echo_us)
// alongside its own clock (t2_us) in TIMESYNC_RESP.
static void sendTimesyncReq() {
  qlcp_server_payload out = {};
  out.packet_type = QLCP_PT_TIMESYNC_REQ;
  out.payload_data.header_only.packet_type = QLCP_PT_TIMESYNC_REQ;
  fillHeader(out.payload_data.header_only.header);
  if (tcp_tx_payload(&s_netLink, &out) != 0) {
    LOG_DEBUG("TIMESYNC_REQ dropped — TX busy");
  }
}

static void qlcpHandlePacket(const qlcp_client_payload& in) {
  switch (in.packet_type) {
    case QLCP_PT_ESTOP: {
      LOG_WARN("QLCP ESTOP received from ground server");
      triggerEStop("QLCP ground command");
      sendStatus(QLCP_PT_ESTOP, in.payload_data.header_only.header.sequence);
      break;
    }
    case QLCP_PT_TIMESYNC_RESP: {
      const uint32_t serverTimeMs = static_cast<uint32_t>(in.payload_data.timesync_resp.t2_us / 1000ULL);
      {
        NodeLock lock;
        s_pendingServerTimeMs = serverTimeMs;
      }
      LOG_DEBUG("QLCP timesync received: %lu ms", static_cast<unsigned long>(serverTimeMs));
      sendAck(QLCP_PT_TIMESYNC_RESP, in.payload_data.timesync_resp.header.sequence);
      break;
    }
    case QLCP_PT_HEARTBEAT: {
      sendAck(QLCP_PT_HEARTBEAT, in.payload_data.header_only.header.sequence);
      break;
    }
    case QLCP_PT_STREAM_START: {
      const uint16_t freq = in.payload_data.stream_start.stream_frequency;
      if (freq > 0U) {
        s_streamFrequencyHz = (freq > kMaxStreamHz) ? kMaxStreamHz : freq;
        s_lastStreamTxMs = millis();
        LOG_DEBUG("QLCP Stream Start at %u Hz", static_cast<unsigned>(s_streamFrequencyHz));
      }
      sendAck(QLCP_PT_STREAM_START, in.payload_data.stream_start.header.sequence);
      break;
    }
    case QLCP_PT_STREAM_STOP: {
      s_streamFrequencyHz = 0U;
      LOG_DEBUG("QLCP Stream Stop");
      sendAck(QLCP_PT_STREAM_STOP, in.payload_data.header_only.header.sequence);
      break;
    }
    case QLCP_PT_CONTROL: {
      const uint8_t cmdId = in.payload_data.control.control_data.id;
      const uint8_t cmdType = in.payload_data.control.control_data.type;
      const uint16_t seq = in.payload_data.control.header.sequence;
      LOG_DEBUG("Received control cmdId=%u type=%u", cmdId, cmdType);
      if (cmdType != QLCP_CONTROL_BOOL) {
        // Every UCM control is a bool valve/relay — nothing else is valid here.
        sendNack(QLCP_PT_CONTROL, seq, QLCP_ERR_INVALID_PARAM);
        break;
      }
      const bool open = (in.payload_data.control.control_data.state.control_bool == QLCP_CS_OPEN);
      // A command to an LCM-owned control is answered immediately; the STATUS
      // reports it PENDING until the LCM confirms, rather than failing the
      // command because the position is not yet known.
      if (setControlByIndex(cmdId, open)) {
        sendStatus(QLCP_PT_CONTROL, seq);
      } else {
        sendNack(QLCP_PT_CONTROL, seq, QLCP_ERR_INVALID_ID);
      }
      break;
    }
    case QLCP_PT_STATUS_REQUEST: {
      sendStatus(QLCP_PT_STATUS_REQUEST, in.payload_data.header_only.header.sequence);
      break;
    }
    default:
      break;
  }
}

static void qlcpNetService(uint32_t nowMs) {
  switch (s_netState) {
    case QLCP_NET_IDLE:
      break;
    case QLCP_NET_WIFI_START:
      LOG_DEBUG("WiFi Connecting to SSID: %s", WIFI_SSID);
      WiFi.begin(WIFI_SSID, WIFI_PASS);
      netTransition(QLCP_NET_WIFI_WAIT, nowMs);
      break;
    case QLCP_NET_WIFI_WAIT:
      if (WiFi.status() == WL_CONNECTED) {
        LOG_DEBUG("WiFi Connected! IP: %s", WiFi.localIP().toString().c_str());
        s_netLink.netif_handle = esp_netif_get_handle_from_ifkey("WIFI_STA_DEF");
        if (discovery_listen_begin(&s_netLink) == ESP_OK) {
          netTransition(QLCP_NET_DISCOVER, nowMs);
        } else {
          netFail(nowMs);
        }
      } else if ((nowMs - s_stateEnteredMs) >= kNetWifiWaitTimeoutMs) {
        LOG_WARN("WiFi connect timeout — retrying");
        WiFi.disconnect();
        netTransition(QLCP_NET_WIFI_START, nowMs);
      }
      break;
    case QLCP_NET_DISCOVER: {
      if (WiFi.status() != WL_CONNECTED) {
        netFail(nowMs);
        break;
      }
      const int found = discovery_listen_service(&s_netLink);
      if (found == 1) {
        discovery_listen_end(&s_netLink);
        if (tcp_connect_begin(&s_netLink) == ESP_OK) {
          netTransition(QLCP_NET_TCP_CONNECT, nowMs);
        } else {
          netFail(nowMs);
        }
      } else if (found < 0) {
        netFail(nowMs);
      }
      break;
    }
    case QLCP_NET_TCP_CONNECT: {
      const int conn = tcp_connect_service(&s_netLink);
      if (conn == 1) {
        if (udp_create_socket(&s_netLink) != ESP_OK) {
          netFail(nowMs);
          break;
        }
        s_configSent = false;
        s_lastRxMs = nowMs;
        s_backoffMs = kNetBackoffMinMs;
        netTransition(QLCP_NET_CONNECTED, nowMs);
      } else if ((conn < 0) || ((nowMs - s_stateEnteredMs) >= kNetTcpConnectTimeoutMs)) {
        netFail(nowMs);
      }
      break;
    }
    case QLCP_NET_CONNECTED: {
      if (WiFi.status() != WL_CONNECTED) {
        netFail(nowMs);
        break;
      }
      if (!s_configSent) {
        qlcp_server_payload out = {};
        out.packet_type = QLCP_PT_CONFIG;
        fillHeader(out.payload_data.config.header);
        out.payload_data.config.config_data = reinterpret_cast<const uint8_t*>(kBoardQlcpConfigJson);
        out.payload_data.config.config_data_len = static_cast<uint16_t>(sizeof(kBoardQlcpConfigJson) - 1U);
        if (tcp_tx_payload(&s_netLink, &out) == 0) {
          s_configSent = true;
          LOG_DEBUG("Sent CONFIG packet to server");
          // Device-initiated timesync starts right after CONFIG; periodic
          // resync cadence (kTimesyncIntervalMs) counts from here.
          sendTimesyncReq();
          s_qlcpTimeSyncJob.lastMs = nowMs;
        }
      }
      if (s_configSent && s_qlcpTimeSyncJob.due(nowMs)) {
        sendTimesyncReq();
      }
      if (tcp_tx_service(&s_netLink) < 0) {
        netFail(nowMs);
        break;
      }
      qlcp_client_payload in = {};
      const int rx = tcp_rx_service(&s_netLink, &in);
      if (rx < 0) {
        netFail(nowMs);
        break;
      }
      if (rx == 1) {
        s_lastRxMs = nowMs;
        s_wifiEStopSafed = false;
        qlcpHandlePacket(in);
      }
      if ((nowMs - s_lastRxMs) >= kNetRxIdleTimeoutMs) {
        LOG_WARN("QLCP server silent — reconnecting");
        netFail(nowMs);
      }
      break;
    }
    case QLCP_NET_BACKOFF:
      if ((nowMs - s_stateEnteredMs) >= s_backoffMs) {
        s_backoffMs = (s_backoffMs >= (kNetBackoffMaxMs / 2U)) ? kNetBackoffMaxMs : (s_backoffMs * 2U);
        if (WiFi.status() != WL_CONNECTED) {
          netTransition(QLCP_NET_WIFI_START, nowMs);
        } else if (discovery_listen_begin(&s_netLink) == ESP_OK) {
          netTransition(QLCP_NET_DISCOVER, nowMs);
        } else {
          netFail(nowMs);
        }
      }
      break;
    default:
      break;
  }
}

static void qlcpTelemetryService(uint32_t nowMs) {
  if ((s_netState != QLCP_NET_CONNECTED) || (s_streamFrequencyHz == 0U)) {
    return;
  }
  const uint32_t periodMs = 1000U / s_streamFrequencyHz;
  if ((nowMs - s_lastStreamTxMs) < periodMs) {
    return;
  }
  s_lastStreamTxMs = nowMs;

  qlcp_sensor_data readings[kSenCount] = {};
  {
    NodeLock lock;
    readings[0].id = kSenPt202;
    readings[0].value = sensorEng(s_sensors[kSenPt202]);

    readings[1].id = kSenPt102;
    readings[1].value = sensorEng(s_sensors[kSenPt102]);

    readings[2].id = kSenVolt24;
    readings[2].value = sensorEng(s_sensors[kSenVolt24]);

    readings[3].id = kSenVsol;
    readings[3].value = sensorEng(s_sensors[kSenVsol]);
  }

  qlcp_data_packet pkt = {};
  fillHeader(pkt.header);
  pkt.sensor_data = readings;
  pkt.sensor_count = kSenCount;

  (void)udp_send_data(&s_netLink, &pkt);
}

// Device-initiated STATUS (spec 7.2): when an LCM Ack/State retires a PENDING
// control the server is told without having asked. Runs here rather than at the
// point of detection because tcp_tx_payload serializes into one static TX buffer
// and is only ever driven from this task.
static void qlcpStatusService() {
  if ((s_netState != QLCP_NET_CONNECTED) || !s_configSent) {
    return;
  }
  bool owed = false;
  {
    NodeLock lock;
    owed = s_statusDirty;
  }
  if (owed) {
    sendStatus(QLCP_PT_NO_ACK, 0U);
  }
}

static void qlcpTask(void* pvParameters) {
  (void)pvParameters;
  for (;;) {
    uint32_t nowMs = millis();
    qlcpNetService(nowMs);
    qlcpStatusService();
    qlcpTelemetryService(nowMs);
    vTaskDelay(pdMS_TO_TICKS(1));
  }
}

// --- AIM Node Interface Implementation ---

static void updateLed(aim::NodeState state) {
  static aim::NodeState s_lastState = static_cast<aim::NodeState>(0xFF);

  if (aimConsoleIsActive()) {
    if (s_lastState != static_cast<aim::NodeState>(0xFE)) {
      s_lastState = static_cast<aim::NodeState>(0xFE);
      neopixelWrite(pins::kRgbData, 255, 191, 0);
    }
    return;
  }

  if (state == s_lastState) return;
  s_lastState = state;
  uint8_t r = 0, g = 0, b = 0;
  switch (state) {
    case aim::NodeState::Nominal:   g = 255; break;           // Green (Healthy / Communicating)
    case aim::NodeState::Fault:     r = 255; g = 180; break; // Yellow (LCM Link Stale >1s)
    case aim::NodeState::SafeState: r = 255; break;           // Red (Timeout >5m / Hardware Safed)
    default:                        b = 255; break;           // Blue (Boot/Init)
  }
  neopixelWrite(pins::kRgbData, r, g, b);
}

void nodeInit() {

  s_nodeMutex = xSemaphoreCreateMutex();

  const int indicatorLeds[] = {pins::kWifiLed, pins::kCanLed, pins::kDebugLed};
  for (size_t i = 0; i < (sizeof(indicatorLeds) / sizeof(indicatorLeds[0])); i++) {
    pinMode(indicatorLeds[i], OUTPUT);
    digitalWrite(indicatorLeds[i], LOW);
  }

  // Controls. defaultOpen = logical state at the de-energized rest:
  // All local controls boot de-energized (safe); remote controls assume the LCM's
  // own boot defaults.
  controlInitLocal (s_controls[kCtrlAv204],     "AV204_VENT", aim::subject::Av204,     pins::kSol1En, true);
  controlInitLocal (s_controls[kCtrlAvSpare],   "AVSPARE",    aim::subject::AvSpare,   pins::kSol2En, true);
  controlInitLocal (s_controls[kCtrlPwrPtUcm],  "PwrPtUcm",   aim::subject::PwrPtUcm,  pins::kVptEn,  true);
  controlInitRemote(s_controls[kCtrlAv203],     "AV203_FILL", aim::subject::Av203,     true);
  controlInitRemote(s_controls[kCtrlAv205],     "AV205_MAIN", aim::subject::Av205,     false);
  controlInitRemote(s_controls[kCtrlPwrSolLcm], "PwrSolLcm",  aim::subject::PwrSolLcm, true);
  controlInitRemote(s_controls[kCtrlPwrPtLcm],  "PwrPtLcm",   aim::subject::PwrPtLcm,  true);

  // Sensors. toEng converts the catalog-scaled wire integer to engineering units.
  sensorInitLocal (s_sensors[kSenPt202],    "Pt202 (Run Tank, local)", aim::subject::Pt202,        0.01f,  "PSI");
  sensorInitLocal (s_sensors[kSenPt102],    "Pt102 (local)",           aim::subject::PtSpare1,     0.01f,  "PSI");
  sensorInitLocal (s_sensors[kSenVolt24],   "24V (Local)",             aim::subject::Volt24Ucm,    0.001f, "V");
  sensorInitRemote(s_sensors[kSenVsol],     "24V (Remote)",            aim::subject::VoltSolLcm,   0.001f, "V");

  ledcSetup(kAdcClockChannel, kAdcClockHz, kAdcClockDuty);
  ledcAttachPin(pins::kAdcClkin, kAdcClockChannel);
  ledcWrite(kAdcClockChannel, 1U);

  SPI.begin(pins::kAdcSclk, pins::kAdcMiso, pins::kAdcMosi, -1);
  s_adc.init();

  s_boardHardwareReady = true;

  // Start WiFi/QLCP state machine
  const uint32_t nowMs = millis();
  s_lastRxMs = nowMs;
  s_lowerLastRxMs = nowMs;
  // No NVS write on every begin() retry; modem power-save drops the association on some APs.
  WiFi.persistent(false);
  WiFi.setSleep(false);
  // Two pad boxes broadcast the same SSID: default fast-scan latches onto the first
  // BSSID heard, signal and subnet be damned. Scan all channels, join the strongest.
  WiFi.setScanMethod(WIFI_ALL_CHANNEL_SCAN);
  WiFi.setSortMethod(WIFI_CONNECT_AP_BY_SIGNAL);
  net_link_init(&s_netLink);
  netTransition(QLCP_NET_WIFI_START, nowMs);

  // Spawn QLCP background task on Core 0 to isolate from main control loop (on Core 1)
  (void)xTaskCreatePinnedToCore(
      qlcpTask,
      "qlcp_task",
      8192U, // Stack size in bytes
      nullptr,
      1U,    // Priority (standard background task)
      nullptr,
      0      // Core 0 (WiFi/LwIP core)
  );

  LOG_INFO("Pegasus UCM hardware initialized");
}

void nodeUpdate(uint32_t nowMs) {
  AIM_ASSERT(s_boardHardwareReady);

  // 5-minute link-loss E-stops (wrap-safe; see linkAgeMs)
  const int32_t wifiAgeMs = linkAgeMs(nowMs, s_lastRxMs);
  const int32_t lcmAgeMs  = linkAgeMs(nowMs, s_lowerLastRxMs);

  if (!s_wifiEStopSafed && wifiAgeMs >= static_cast<int32_t>(kNetEStopTimeoutMs)) {
    s_wifiEStopSafed = true;
    LOG_INFO("E-Stop: WiFi/QLCP link loss, age=%ld ms", static_cast<long>(wifiAgeMs));
    triggerEStop("WiFi/QLCP link loss (5m)");
  }
  if (!s_lcmEStopSafed && lcmAgeMs >= static_cast<int32_t>(kLowerEStopTimeoutMs)) {
    s_lcmEStopSafed = true;
    LOG_INFO("E-Stop: Lower Control CAN link loss, age=%ld ms", static_cast<long>(lcmAgeMs));
    triggerEStop("Lower Control CAN link loss (5m)");
  }

  updateLed(nodeCurrentState());

  // Sample PTs every tick (ADC read is non-blocking; jobs gate only CAN sends)
  {
    int32_t rawData[kAdcChannelCount] = {0};
    if (s_adc.readChannels(rawData)) {
      float volts[kAdcChannelCount] = {0.0f};
      s_adc.computeVoltages(rawData, volts);
      NodeLock lock;
      sensorSampleEng(s_sensors[kSenPt202], processPT(volts[kAdcChPt202], kPt202MaxPsi));
      sensorSampleEng(s_sensors[kSenPt102], processPT(volts[kAdcChPt102], kPt102MaxPsi));
    }
  }

  // Voltage sense every tick
  {
    float local24v = (static_cast<float>(analogRead(pins::kSense24v)) / 4095.0f) * 3.3f * 11.0f;
    NodeLock lock;
    sensorSampleEng(s_sensors[kSenVolt24], local24v);
  }

  // LCM link staleness check
  {
    NodeLock lock;
    const bool currentlyUp = linkAgeMs(nowMs, s_lowerLastRxMs) < static_cast<int32_t>(kLowerStaleTimeoutMs);
    if (currentlyUp != s_lowerLinkUp) {
      s_lowerLinkUp = currentlyUp;
      LOG_DEBUG("Lower Control link %s", s_lowerLinkUp ? "UP" : "STALE");
    }
  }

  // An LCM Ack/State — or a console command — can change the control picture at
  // any time, on this core. Latch the divergence; qlcpTask does the sending.
  {
    NodeLock lock;
    if (statusFingerprint() != s_reportedFingerprint) {
      s_statusDirty = true;
    }
  }
}

void nodeServiceLog(uint32_t nowMs, AimFlightRecorder& recorder) {
  if (!s_logJob.due(nowMs)) return;

  // Column order must match kLogHeaders: time, 4 sensors (catalog-scaled ints), 7 controls in enum order.
  uint32_t rowData[kLogCols] = {0};
  {
    NodeLock lock;
    rowData[0] = nowMs;
    rowData[1] = static_cast<uint32_t>(s_sensors[kSenPt202].value);
    rowData[2] = static_cast<uint32_t>(s_sensors[kSenPt102].value);
    for (uint8_t i = 0U; i < kCtrlCount; i++) {
      rowData[5U + i] = static_cast<uint32_t>(controlGet(s_controls[i]));
    }
  }

  recorder.writeRow(rowData, nowMs);
}

void nodeServiceCanTx(uint32_t nowMs, AimNetwork& aim) {
  AIM_ASSERT(s_boardHardwareReady);

  // 50 Hz telemetry broadcast (24 V sense & local valve states)
  if (s_telemetryJob.due(nowMs)) {
    aim::Msg solMsg = {};
    {
      NodeLock lock;
      sensorBuildFrame(s_sensors[kSenVolt24], solMsg);
    }
    (void)aim.send(solMsg);

    for (uint8_t i = kCtrlAv204; i <= kCtrlAvSpare; i++) {
      aim::Msg sm = {};
      {
        NodeLock lock;
        controlBuildState(s_controls[i], sm);
      }
      (void)aim.send(sm);
    }
  }

  // Service control CAN traffic: remote Cmd (re)sends.
  {
    NodeLock lock;
    for (uint8_t i = 0U; i < kCtrlCount; i++) {
      controlServiceTx(s_controls[i], nowMs, aim);
    }
  }

  // Apply pending server time sync from QLCP (under NodeLock)
  uint32_t syncTimeMs = 0U;
  {
    NodeLock lock;
    syncTimeMs = s_pendingServerTimeMs;
    s_pendingServerTimeMs = 0U;
  }
  if (syncTimeMs > 0U) {
    aim.syncTime(syncTimeMs);
    LOG_DEBUG("AimNetwork master time synced to server: %lu ms", static_cast<unsigned long>(syncTimeMs));
  }

  // 1 Hz CAN TimeSync broadcast (UCM is the network master)
  if (s_timeSyncCanJob.due(nowMs)) {
    aim::Msg tsMsg = {};
    tsMsg.cls     = aim::Class::Time;
    tsMsg.subject = aim::subject::TimeSync;
    (void)aim.send(tsMsg);
  }
}

void nodeOnRx(const aim::Msg& m, uint32_t nowMs) {
  // Events (LowPower etc.) are telemetry only — no automatic control action.
  if (m.cls == aim::Class::Event) {
    return;
  }

  if (m.source != aim::Source::Lcm) {
    return;
  }

  NodeLock lock;
  s_lowerLastRxMs = nowMs;
  s_lcmEStopSafed = false;

  if (m.cls == aim::Class::Ack || m.cls == aim::Class::State) {
    // Route the LCM's Ack/State to whichever remote control owns the subject.
    for (uint8_t i = 0U; i < kCtrlCount; i++) {
      (void)controlOnRx(s_controls[i], m);
    }
  } else if (m.cls == aim::Class::Sensor) {
    for (uint8_t i = 0U; i < kSenCount; i++) {
      if (sensorOnRx(s_sensors[i], m)) {
        break;
      }
    }
  }
}

aim::NodeState nodeCurrentState() {
  const uint32_t nowMs = millis();
  if (linkAgeMs(nowMs, s_lastRxMs) >= static_cast<int32_t>(kNetEStopTimeoutMs) ||
      linkAgeMs(nowMs, s_lowerLastRxMs) >= static_cast<int32_t>(kLowerEStopTimeoutMs)) {
    return aim::NodeState::SafeState; // Red
  }
  return s_lowerLinkUp ? aim::NodeState::Nominal : aim::NodeState::Fault; // Green vs Yellow
}

uint16_t nodeErrorBits() {
  return 0U;
}

#ifndef FLIGHT_BUILD
// "UNKNOWN" until the LCM's first State frame confirms a remote control.
static void hookStatusSnapshot(Stream& out) {
  NodeLock lock;
  for (uint8_t i = 0U; i < kCtrlCount; i++) {
    out.printf("%-12s %s\n", s_controls[i].name,
               aim::controlStr(s_controls[i]));
  }
  for (uint8_t i = 0U; i < kSenCount; i++) {
    const aim::Sensor& s = s_sensors[i];
    if (sensorFresh(s)) {
      out.printf("%-26s %.2f %s\n", s.name, sensorEng(s), s.unit);
    } else {
      out.printf("%-26s UNKNOWN\n", s.name);
    }
  }
}

static void hookNetworkStatus(Stream& out) {
  NodeLock lock;
  out.printf("net=%s ip=%s rssi=%d qlcp=%u svr=%s:%u/%u stream=%uHz lower=%s\n",
    WIFI_SSID, WiFi.localIP().toString().c_str(), WiFi.RSSI(),
    s_netState,
    s_netLink.server_ip, s_netLink.server_tcp_port, s_netLink.server_udp_port,
    static_cast<unsigned>(s_streamFrequencyHz),
    s_lowerLinkUp ? "OK" : "STALE");
}

static void hookSetValve(Stream& out) {
  int index = aimConsoleWaitRead(out);
  if (index == ' ') {
    index = aimConsoleWaitRead(out);
  }
  if (index < '0' || index > '6') {
    NodeLock lock;
    for (uint8_t i = 0U; i < kCtrlCount; i++) {
      out.printf("  %u: %-12s %s\n", i, s_controls[i].name,
                 aim::controlStr(s_controls[i]));
    }
    out.println("Usage: v <0-6> <0|1>");
    return;
  }
  uint8_t ctrlIdx = index - '0';
  int state = aimConsoleWaitRead(out);
  if (state == ' ') {
    state = aimConsoleWaitRead(out);
  }
  if (state < '0' || state > '1') {
    out.println("Usage: v <0-6> <0|1>");
    return;
  }
  bool isOpen = (state == '1');
  if (setControlByIndex(ctrlIdx, isOpen)) {
    out.printf("%s -> %s\n", s_controls[ctrlIdx].name, isOpen ? "OPEN/ON" : "CLOSED/OFF");
  } else {
    out.println("Set control failed");
  }
}

static const AimConsoleHook s_consoleHooks[] = {
  {'p', "status snapshot", hookStatusSnapshot},
  {'n', "network status", hookNetworkStatus},
  {'v', "valve/FET control", hookSetValve},
};

const AimConsoleHook* nodeConsoleHooks(uint8_t& count) {
  count = sizeof(s_consoleHooks) / sizeof(s_consoleHooks[0]);
  return s_consoleHooks;
}
#endif
