Queens-Rocket-Engineering-Team/av-prop/(commit log)

2026-05-31 Refactor console and node modules to enhance functionality and improve structure
    - Updated platformio.ini to enable MOCK_HARDWARE for testing.
    - Expanded ConsoleMenu in console.cpp to include network, CAN node, and IO control options.
    - Enhanced showMenu function to display new menu options and handle user input for network, CAN, and IO control.
    - Added new console actions in console.h for network, CAN, and IO control.
    - Refactored main.cpp to streamline state transitions and improve watchdog functionality.
    - Updated node.cpp to include additional sensor and valve configurations, and improved telemetry handling.
    - Removed pinouts.h and integrated pin definitions directly into node.h for bett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
2026-06-10 Baseline: board/console split, AimFlashStorage integration, refactor plan
    Replaces node.cpp with board.cpp/board.h hardware hooks, integrates the
    renamed AimFlashStorage library (config store, flight recorder, littlefs
    partition), adds partitions.csv, CLAUDE.md, project skills, and the
    phased refactor plan. Submodule pin: av-libraries feature/aim-flash-storage.
    [partitions.csv]
2026-06-10 Add board_config module as sole owner of on-flash configuration
    board_config.cpp now owns the /config.json path, key layout, telemetry
    schema injection, and the safe storage-format path (quiesce recorder via
    closeLog before format — fixes the lfs_file_size assert after console
    erase). main.cpp boot collapses to configEnsureTelemetrySchema +
    configLoadBoard with distinct not-present/read-failed/parse-failed logging.
    Behavior change: the telemetry schema file is now created on first boot of
    a fresh filesystem (previously only injected if a config already existed).
    Submodule pin: AimFlashStorage 0.2.0 (closeLog, loadDetailed).
    [main.cpp]
2026-06-10 Console becomes view/controller: config ops via board_config, restricted post-erase mode
    - Deletes from console.cpp: /config.json path, JsonDocument construction,
    direct format()/removeFile()/streamFile(); consoleInit drops the
    AimConfigStore dependency (8 refs -> 7).
    - sav/rst/jsn dispatch to configSaveBoard/configResetBoard/configPrintBoard;
    the reboot warning prints only when canId differs from the boot value;
    rst now shows RAM vs flash state distinctly.
    - Erase confirm calls storageFormatForMaintenance (recorder quiesced before
    format) and enters a restricted mode: FLS menu offers only back/exit until
    reboot, deleting every post-format dump/config edge case.
    - extract_tool se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
    [main.cpp]
2026-06-10 Flatten WiFi/QLCP FreeRTOS tasks into non-blocking main-loop services
    wifi/ becomes a FreeRTOS-free socket layer (net_link_t): non-blocking SSDP
    listen (begin/service/end), O_NONBLOCK TCP connect polled via zero-timeout
    select, incremental RX assembler (<=512 B/tick, one decoded packet/tick),
    pending-buffer TX (<=1 KB/tick, holds the 2.4 KB CONFIG packet), and lossy
    UDP telemetry sends. network_manager.c and all six tasks are deleted.
    board.cpp drives a flat QlcpNetState switch (WIFI_START -> WIFI_WAIT ->
    DISCOVER -> TCP_CONNECT -> CONNECTED -> BACKOFF with 1-8 s doubling retry)
    from boardUpdate() every tick — including DEBUG_CONSOLE, so heartbeat ACKs
    continue while an operator is in the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
2026-06-10 console: mute logger during binary flash dump; bump av-libraries
    A binary dump shares the UART with the ASCII logger; an async LOG_* line
    mid-stream corrupts a block (no checksums in the protocol). Save the
    logger filter mask when the dump starts and restore it on both the
    'b'-cancel and dump-complete paths.
    av-libraries pin picks up the dump-protocol fixes (final-block padding,
    extract_tool double-Ctrl-A entry, per-block acks, bounded retries).
    Verified on bench ESP32-S3: fresh flash, full extract_tool dump
    (531 rows, 8 cols, padded final block), 19/19 Phase 1 console checks.
2026-06-10 Upper_Control: simplify pass — fix CAN telemetry type, dedupe QLCP fill, move flags down
    - board.cpp: fix s_sendFloatTelemetry assigning pkt.dest twice; the second
    assignment was meant to be pkt.type = AIM_TYPE_SENSOR, so CAN telemetry
    went out with the wrong dest and type 0. Needs CAN-side verification.
    - board.cpp: fold the five duplicated qlcp_header sequence/timestamp fills
    into s_fillHeader(); name the hardcoded 4U control/sensor counts.
    - console.cpp/board_config: replace the console-local s_storageResetPending
    with configRebootRequired() latched by storageFormatForMaintenance(), and
    drop s_dumpSavedLogMask now that AimFlightRecorder owns the dump mute.
    - bump av-libraries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
2026-06-10 Upper_Control: delete dead console API and surface; bump av-libraries
    - console no longer takes AimNetwork (stored but never used) and
    consoleResume() is gone (never called)
    - g_ptValues/g_valveStates declared in board.h instead of function-local
    externs in main.cpp
    - av-libraries pin: drops AimFileSystem::streamFile()/getConfig() (no
    callers) and picks up the _trackedOrigins removal in AimNetwork
    [main.cpp]
2026-06-11 Upper_Control: add AimTxPolicy transmit layer; fix heartbeat bug
    Centralises all CAN TX scheduling into AimTxPolicy (periodic + latched
    slots) owned by board.cpp. Eliminates scattered per-module timers,
    removes the never-compiling sendTimedPktEx call, and fixes the inverted
    !packData condition that silently suppressed every heartbeat transmission.
    serviceTx() deleted; runStateMachine calls boardServiceTx directly.
    Bump av-libraries submodule to pick up aim_tx_policy.{h,cpp}.
    [main.cpp]
2026-06-11 Upper_Control: promote config and inline transmit scheduling
    Replace board_config with shared AimNodeConfig, remove AimTxPolicy usage, inline periodic and latched CAN transmit behavior, and clean up local naming conventions.
    Bump av-libraries to the commit containing AimNodeConfig and the TxPolicy removal.
    [main.cpp]
2026-06-11 av-prop: simplification pass and pin bump (crystalline-exploring-pebble.md)
2026-06-11 av-prop: Upper_Control naming convention cleanup (crystalline-exploring-pebble.md)
2026-06-11 remove references to aim framework in lower fw and update hall library for better dependency injection
2026-06-15 av-prop: drop vendored av-libraries submodule, build against workspace copy
    Remove Firmware/av-libraries submodule and its .gitmodules entry; point
    Upper_Control lib_extra_dirs at the workspace ../../../av-libraries/.
2026-06-15 av-prop: migrate Upper_Control to node.* convention
    Replace board.*/console.* with node.{cpp,h} + pinouts.h and a thin
    main.cpp (wiring only). Rename env Upper_Control -> HYDRA, 16MB flash /
    app0 partition layout.
    [partitions.csv]
2026-06-15 av-prop: add Lower_Control project and refresh Firmware README
2026-06-17 fixed: CS pinMode with no pin connected in ADC lib init()
2026-06-18 libraries: add aim_control control model; TMAG5273 getFluxMagnitude
    aim_control is one tagged Control type for actuated outputs on the CAN bus:
    Local controls own a GPIO (de-energized = safe, per-control openLevel) and
    answer Cmd with Ack/State; Remote controls are commanded over CAN with
    seq/retry and tracked via the owner's Ack/State (confirmed only on State).
    TMAG5273 gains getFluxMagnitude() = sqrt(x^2+y^2+z^2), reusing getAllFlux.
2026-06-18 Upper/Lower Control: migrate valves/relays to aim_control
    Replace the hand-rolled valve state + remote CMD/ACK retry queues on both
    boards with a shared aim::Control[] array. Controls and PTs are indexed by
    catalog subject name (kCtrlAv204, kPtPt202, ...) so local vs remote sourcing
    is explicit. UCM shows UNKNOWN for remote controls until the LCM's first
    State confirms them. Pass nowMs into service(); drop CORE_DEBUG_LEVEL spam.
    [main.cpp, node.cpp, node.h]
2026-06-21 Upper/Lower Control: aim_sensor + aim_control refactor, fix QLCP sensor_id duplication
    Extract sensor abstraction into aim_sensor library. Simplify aim_control
    polarity model to single defaultOpen bool (removing openLevel). Add
    controlStr() and control name field. Clean up PropTesting constants to
    constexpr kCamelCase. Fix duplicate sensor_id=8 in UCM qlcpTelemetryService
    (now uses UcmSensor enum values). Remove vendored av-libraries submodule.
    [main.cpp, node.cpp, node.h, pinouts.h, upper_test.cpp]
2026-07-04 Consolidate shared libraries and improve node thread-safety
2026-07-27 feat(prop_testing): add optional maxPsi parameter to processPT
    Allows callers to specify custom pressure transducer PSI range scale
    overrides while defaulting to kPtMaxPsi (2000 PSI).
2026-07-27 refactor(Lower_Control): upgrade CAN baud to 1 Mbps, tighten link watchdog, and organize node namespace
    - Update CAN baud rate to 1000000U (1 Mbps) and use AimCanHardware
    - Add node::kSource = aim::Source::Lcm to namespace node in node.h
    - Tighten kUpperStaleTimeoutMs to 2.0s link watchdog paired with UCM keepalives
    - Add Class::Event to CAN accept mask for dynamic TelemetryMode rate switching
    [main.cpp, node.cpp, node.h]
2026-07-27 refactor(Upper_Control): streamline UCM telemetry, server time sync, and thread safety
    - Add node::kSource = aim::Source::Ucm to namespace node in node.h
    - Queue QLCP server time in s_pendingServerTimeMs under NodeLock for aim.syncTime()
    - Implement -1, 0, 1 state integer trick (s_pendingTelemetryMode) for CAN TelemetryMode event
    - Combine 2 Hz 24V sense and valve state CAN broadcasts into s_telemetryJob
    - Rename s_timesyncJob to s_qlcpTimeSyncJob and add 1 Hz s_timeSyncCanJob
    - Streamline BoardTelemetryCol enum to 6 columns
    - Bypass flash storage initialization in main.cpp while aim_flash_storage is under background dev
    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
2026-08-14 refactor(prop): configure QRET-PAD WiFi, add periodic 1Hz rate sync, prune dead sensors, and align node interfaces
2026-08-14 feat(prop): handle LowPower event in UCM by returning controls to safe default
2026-08-18 feat(prop): pre-launch UCM/LCM build — AVSPARE on, fixed rates, QLCP hardening, PT+valve flash log
    UCM: AVSPARE (SOL2) re-enabled as control 1; rate mode removed (50 Hz CAN telemetry,
    20 Hz flight log of PTs/voltages/all control states); LowPower no longer safes controls;
    WARN/ERROR logging enabled; STREAM_START clamped to 500 Hz; WiFi persistent/sleep off,
    RX-idle 30 s, backoff 500-2000 ms; watchdog 10 s armed after init; CORE_DEBUG_LEVEL=3
    (bench). NOTE: WIFI_SSID is the bench network — set QRET-PAD and CORE_DEBUG_LEVEL=0 for
    the pad build.
    LCM: single-rate jobs; watchdog 10 s armed after init.
    [main.cpp, node.cpp, node.h]
2026-08-18 fix(ucm): console back on native USB (CDC on boot) with non-blocking TX
    The board has no UART bridge — Serial must be the USB-Serial-JTAG CDC or the console is
    dead. setTxTimeoutMs(0) keeps an unplugged host from stalling the loop (100 ms per write).
    [main.cpp]
2026-08-18 chore(lcm): bench build — enable WARN/ERROR/DEBUG logging (revert to INFO for the pad build)
    [main.cpp]
2026-08-18 fix(ucm): CDC tx timeout 20 ms — keep log lines intact without pad stalls
    [main.cpp]
2026-08-19 chore(prop): INFO-only logging on UCM and LCM
2026-08-19 fix 5 minute estop timer
    [main.cpp, node.cpp]
